paenian/bb8/bb8_club/PLAN B Body Panel Decals/Plan B Decal 1.jpg

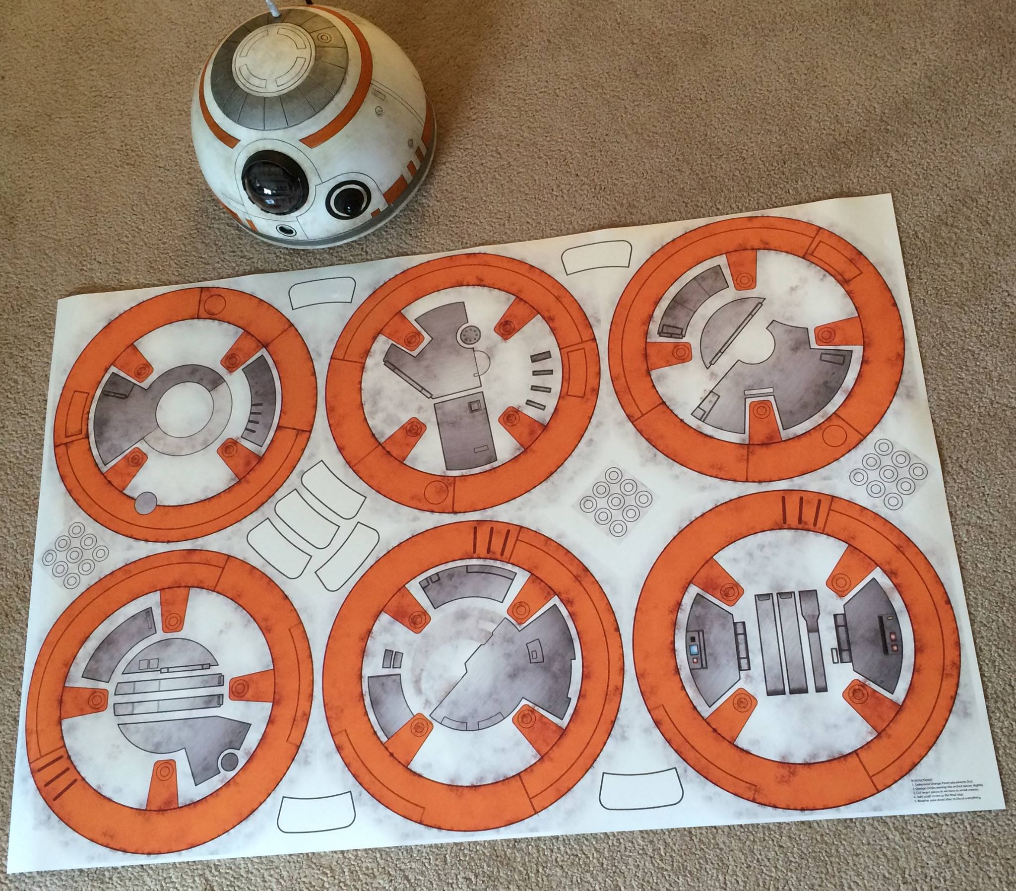
bb8_club/PLAN B Body Panel Decals/Plan B Decal 1.jpg
