paenian/bb8/bb8_club/Dome STL Files/Quarter Cut STL/READ ME - T&M BB8 Quarter Cut Part Files.rtf

For those with smaller X & Y build areas, like the FlashForge, Dremel, MakerBot Mini. Tiny has developed these Quarter Cut pieces.

These work just like the regular pieces, however instead of being 3 pieces to make a complete part, such as Dome Ring, Dome Skirt or even the Dome Panels, it requires you to print all 4 pieces.

The Dome Ring, you will notice is just 1 (one) STL part file, however you will need to print the file 4 times. This is indicated in the file name of the part by the x4 nomenclature.

Where as the Dome Skirt is actually only 2 (two) STL part files, and you will print each of those twice (x4). This is indicated in the file name of the part by the x2 nomenclature.
