paenian/bb8/bb8_club/Dome STL Files/Logic Mesh.pdf

LED Panel Mesh Dome

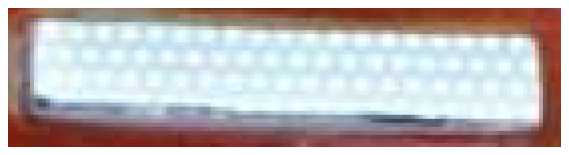
[picture p26: figure]

Approx. 23mm x 4mm
