paenian/bb8/bb8_club/Body Stage STL Files/T&M Body Panel Orientation -Sheet Layout.pdf

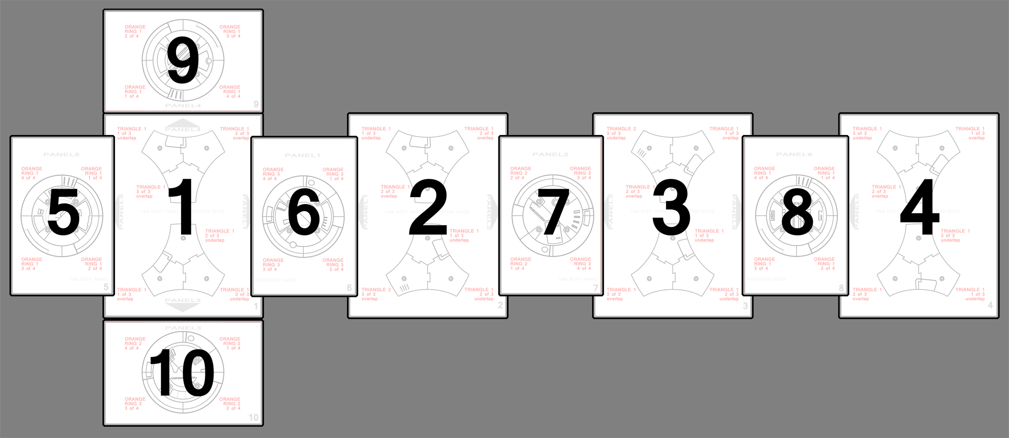
[picture p27: page 1]
