paenian/bb8/bb8_club/Body Stage STL Files/Orange Rings/Orange Ring 1 Orientation.jpg

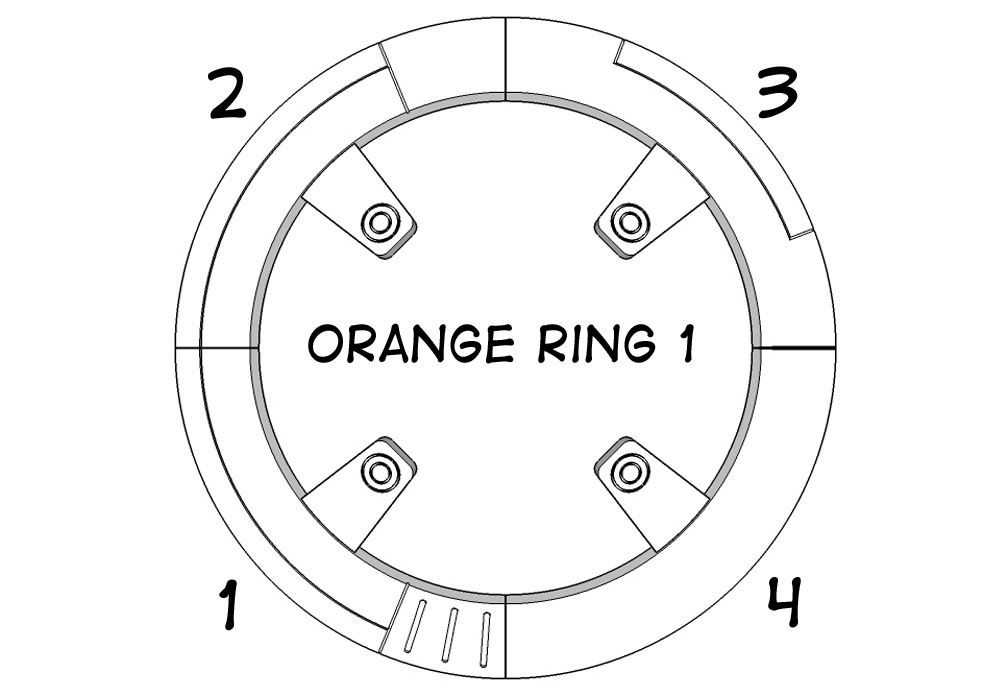
bb8_club/Body Stage STL Files/Orange Rings/Orange Ring 1 Orientation.jpg
