paenian/bb8/bb8_club/Body Stage STL Files/Orange Rings/Orange Ring 3 Orientation.jpg

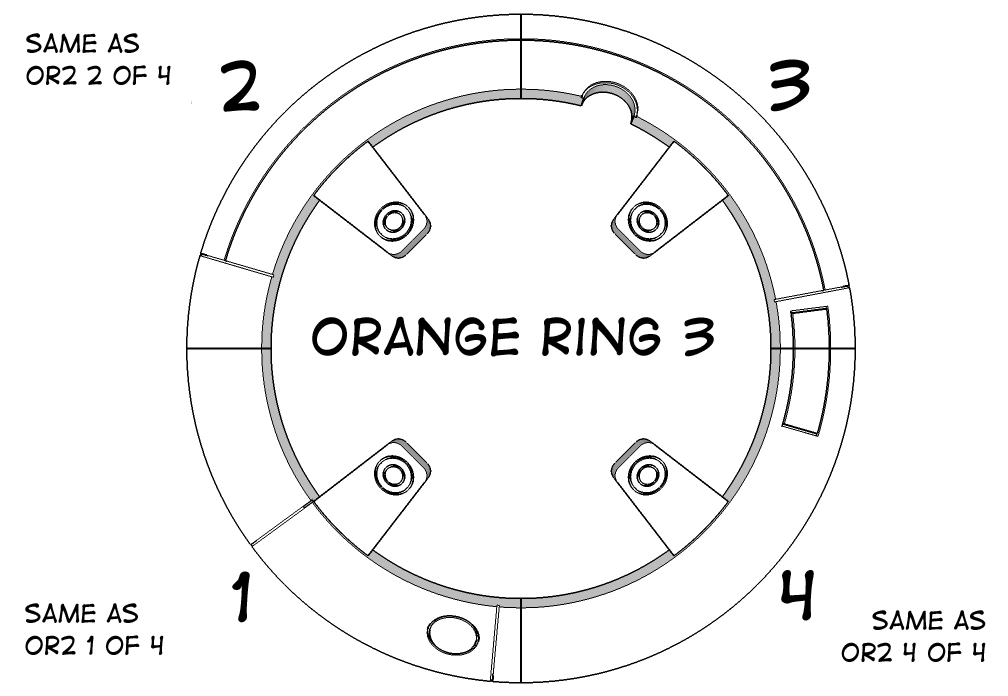
bb8_club/Body Stage STL Files/Orange Rings/Orange Ring 3 Orientation.jpg
