paenian/bb8/bb8_club/BB-8 Parts for Large Format Printers/Triangle 2.stl

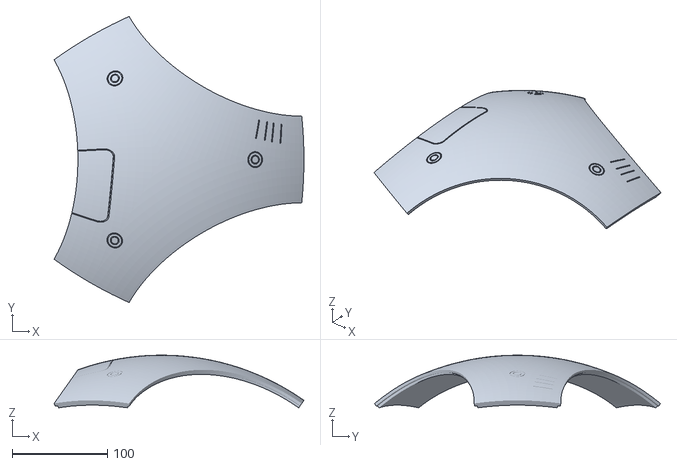
[picture p31: CAD file, 2018-01-01]
bb8_club/BB-8 Parts for Large Format Printers/Triangle 2.stl
262.7 x 300.6 x 55.4
