paenian/bb8/bb8_club/Body Stage STL Files/Panels/Panel 4 V506mm 1 of 2 -1mm.stl

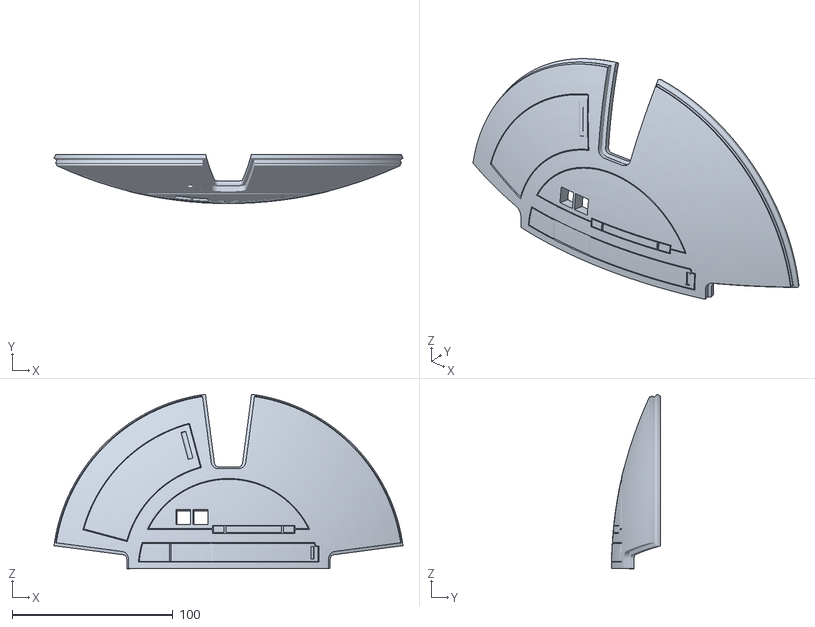
[picture p33: CAD file, 2018-01-01]
bb8_club/Body Stage STL Files/Panels/Panel 4 V506mm 1 of 2 -1mm.stl
217.2 x 30.6 x 108.6
