paenian/bb8/bb8_club/Body Stage STL Files/Triangles/Triangle2 - 3 of 3 - underlap.stl

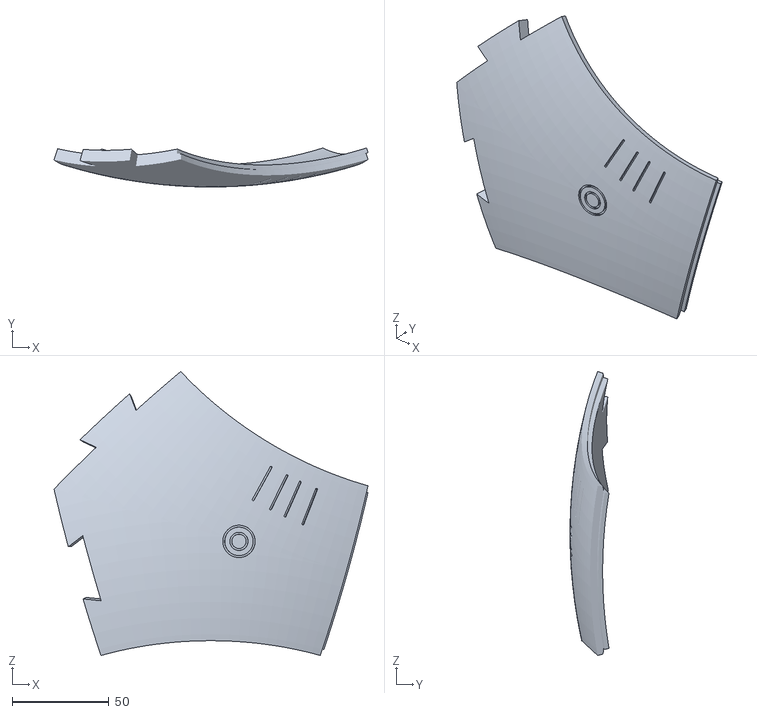
[picture p34: CAD file, 2018-01-01]
bb8_club/Body Stage STL Files/Triangles/Triangle2 - 3 of 3 - underlap.stl
162.3 x 20.2 x 146.8
