paenian/bb8/bb8_club/Dome STL Files/BB8 Pie Panel 1 V2 mag.stl

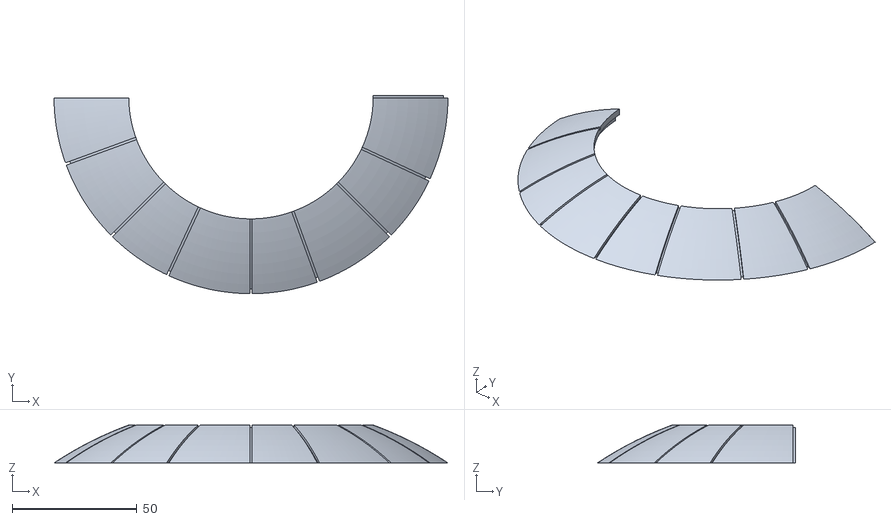
[picture p35: CAD file, 2018-01-01]
bb8_club/Dome STL Files/BB8 Pie Panel 1 V2 mag.stl
158.0 x 79.5 x 15.2
