paenian/bb8/bb8_club/Dome STL Files/Quarter Cut STL/BB8 Dome Ring QTR x4.stl

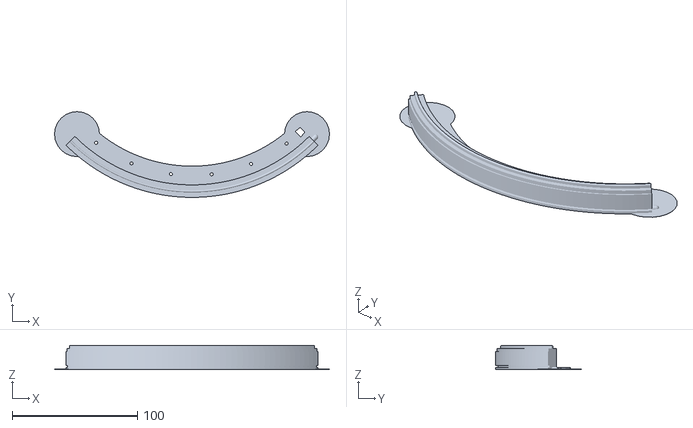
[picture p36: CAD file, 2018-01-01]
bb8_club/Dome STL Files/Quarter Cut STL/BB8 Dome Ring QTR x4.stl
219.8 x 68.6 x 19.4
