paenian/bb8/bb8_club/Hamster/BMM Tube Template v2.stl

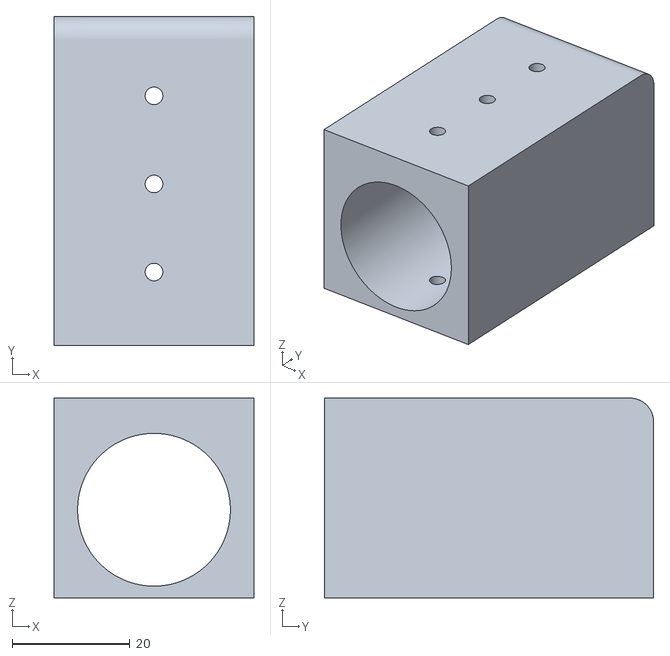
[picture p37: CAD file, 2018-01-01]
bb8_club/Hamster/BMM Tube Template v2.stl
34.0 x 56.0 x 34.0
