paenian/bb8/body/cuboctahedron/pyramid.stl

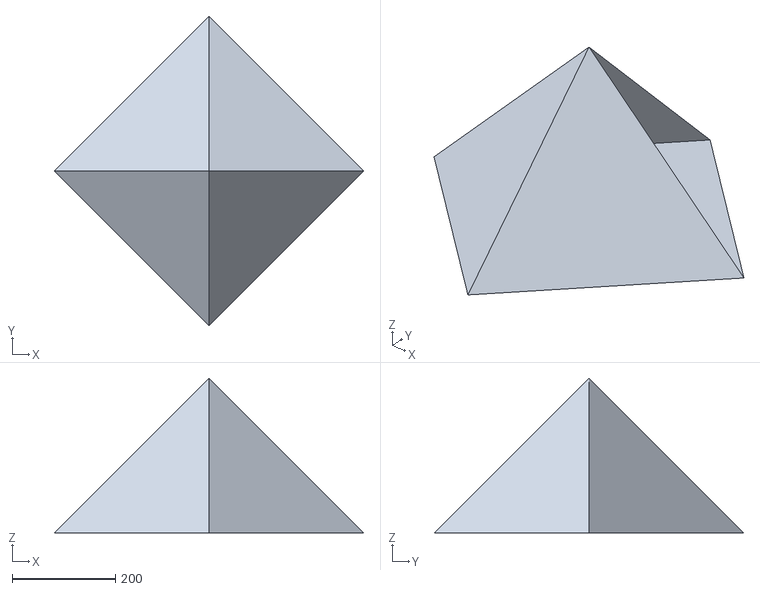
[picture p38: CAD file, 2017-08-08]
body/cuboctahedron/pyramid.stl
600.0 x 600.0 x 300.0
