paenian/bb8/body/rhombicuboctahedron/assembled/face4.stl

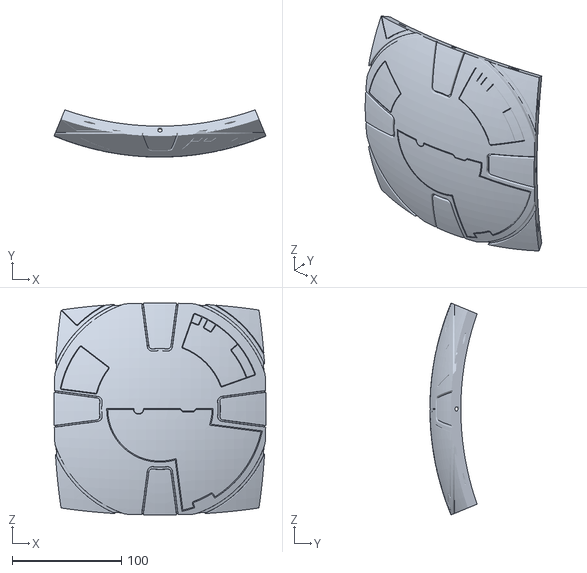
[picture p39: CAD file, 2016-05-04]
body/rhombicuboctahedron/assembled/face4.stl
194.3 x 43.3 x 194.2
