paenian/bb8/body/rhombicuboctahedron/assembled2/face24.stl

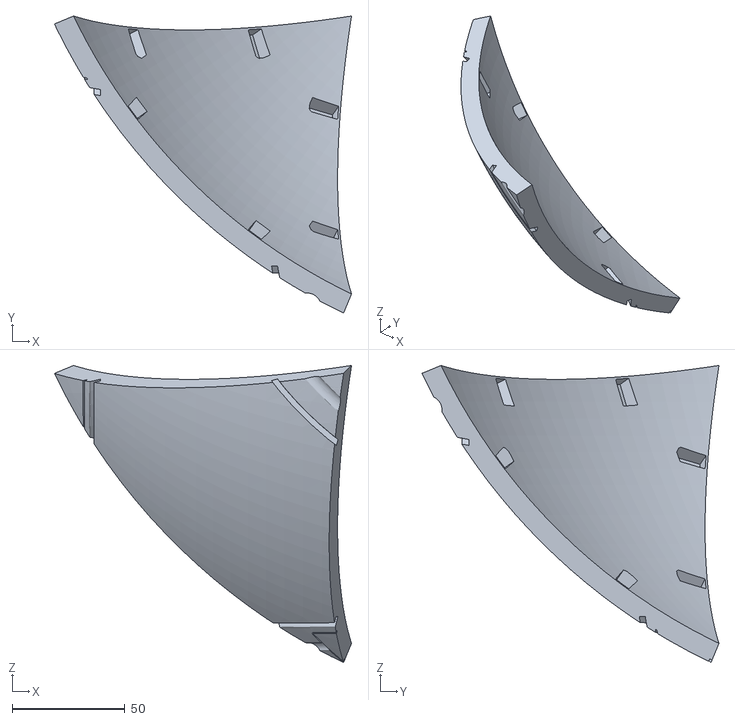
[picture p40: CAD file, 2016-05-06]
body/rhombicuboctahedron/assembled2/face24.stl
131.8 x 131.8 x 131.8
