paenian/bb8/body/rhombicuboctahedron/dodeca_half.stl

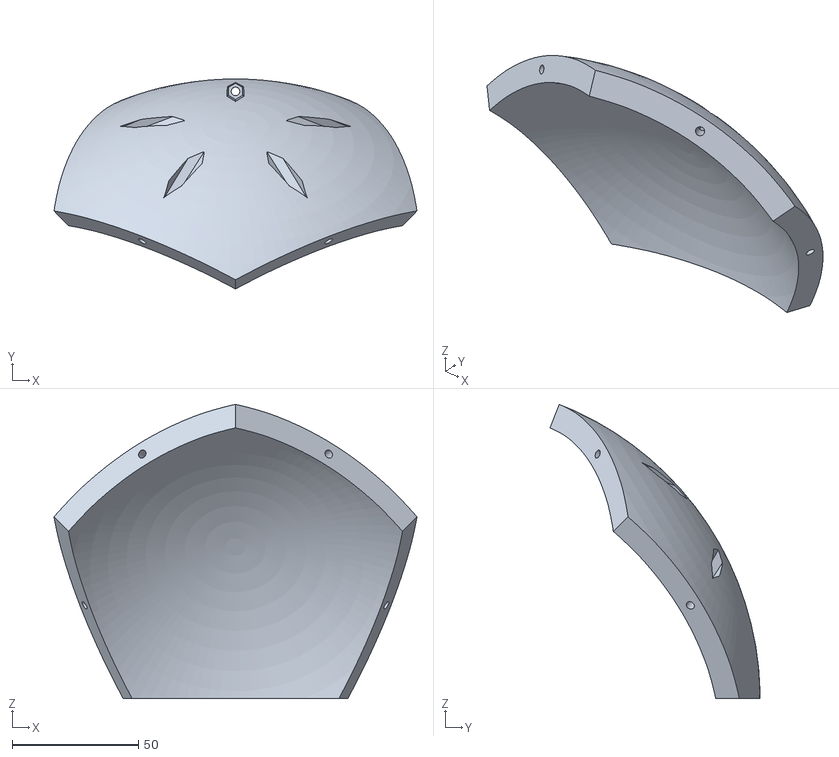
[picture p41: CAD file, 2016-04-13]
body/rhombicuboctahedron/dodeca_half.stl
143.5 x 83.1 x 116.3
