paenian/bb8/body/rhombicuboctahedron/printing/face0.stl

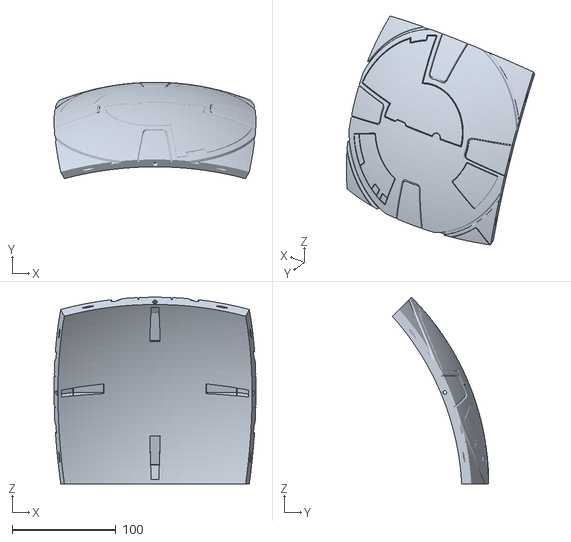
[picture p42: CAD file, 2016-05-04]
body/rhombicuboctahedron/printing/face0.stl
194.3 x 92.7 x 179.5
