paenian/bb8/body/rhombicuboctahedron/printing2/face14.stl

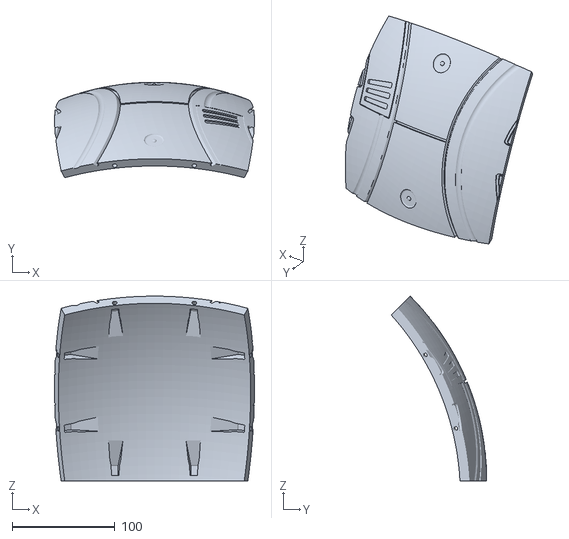
[picture p43: CAD file, 2016-05-06]
body/rhombicuboctahedron/printing2/face14.stl
194.3 x 92.8 x 179.5
