paenian/bb8/body/rhombicuboctahedron_clean/assembled/face21.stl

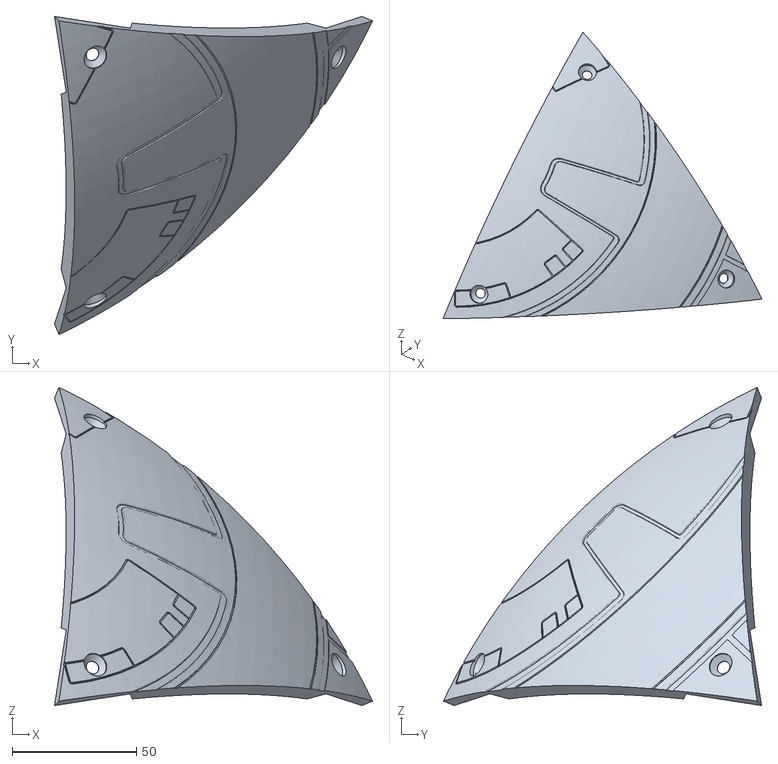
[picture p44: CAD file, 2016-11-15]
body/rhombicuboctahedron_clean/assembled/face21.stl
128.1 x 128.1 x 128.1
