paenian/bb8/body/rhombicuboctahedron_clean/printing/face19.stl

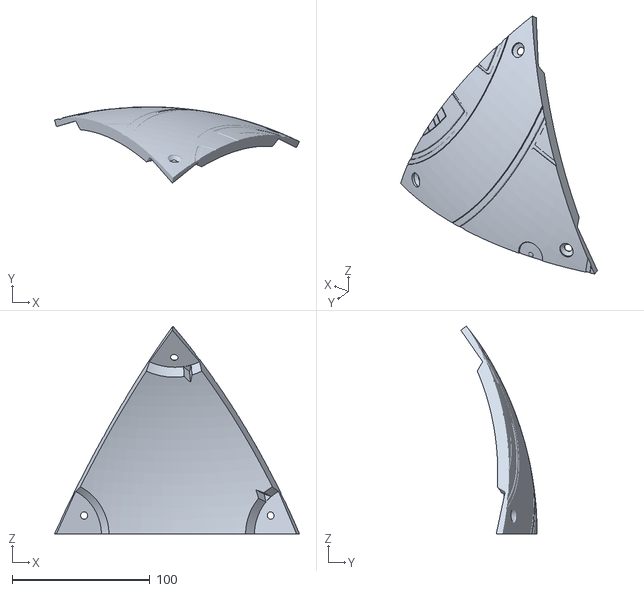
[picture p45: CAD file, 2016-11-15]
body/rhombicuboctahedron_clean/printing/face19.stl
178.0 x 55.5 x 150.9
