paenian/bb8/body/thermoformer/form_sixth.stl

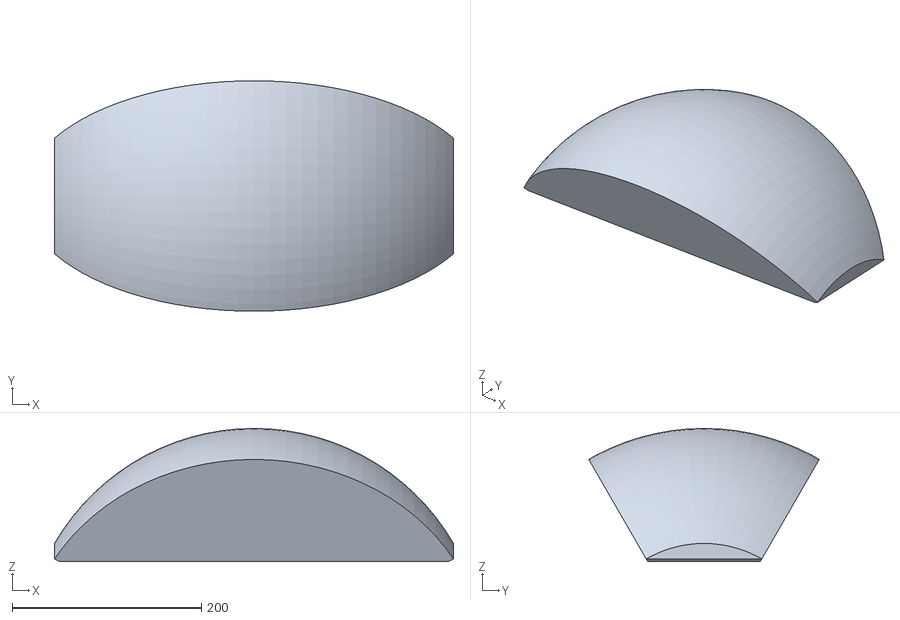
[picture p46: CAD file, 2016-06-22]
body/thermoformer/form_sixth.stl
421.4 x 243.4 x 140.6
