paenian/bb8/body/thermoformer/printing/waistband.stl

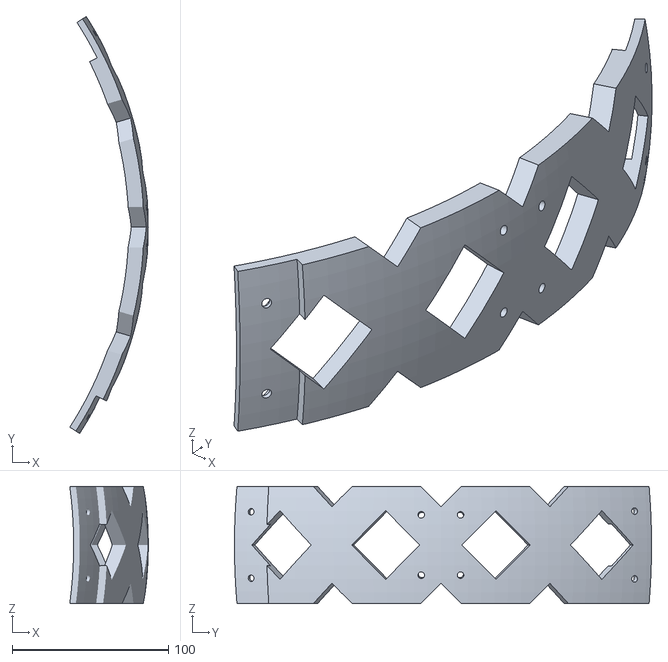
[picture p47: CAD file, 2016-08-10]
body/thermoformer/printing/waistband.stl
50.2 x 266.6 x 75.0
