paenian/bb8/code/edsjunk/Control/BodyBottom.stl

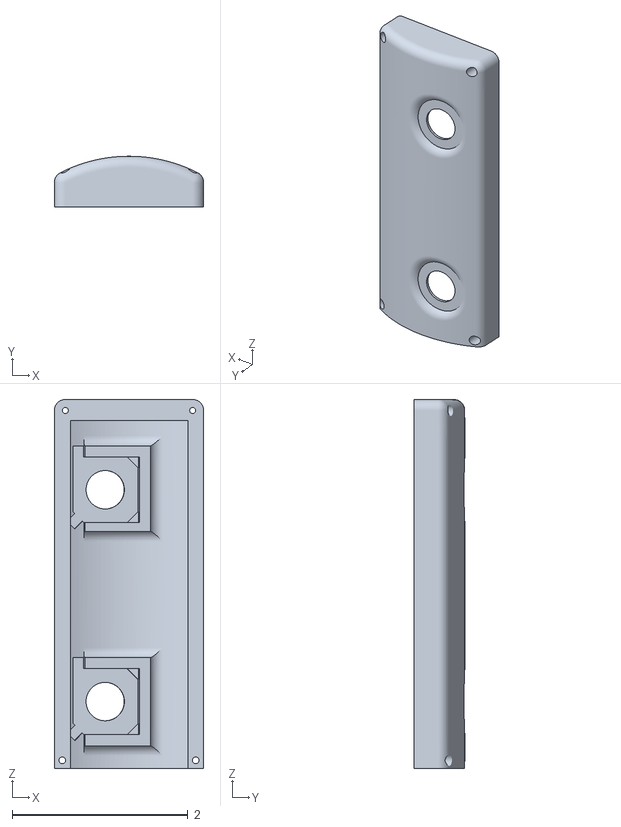
[picture p48: CAD file, 2016-06-22]
code/edsjunk/Control/BodyBottom.stl
1.70 x 0.575 x 4.20
