paenian/bb8/controller/top.stl

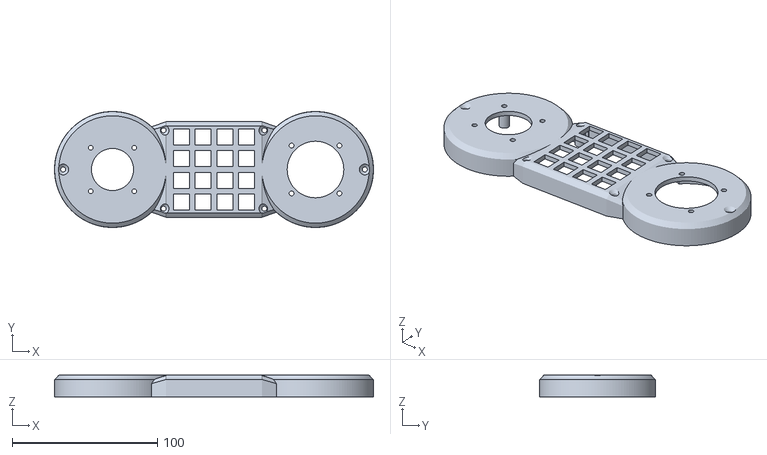
[picture p49: CAD file, 2017-02-14]
controller/top.stl
220.0 x 80.0 x 15.0
