paenian/bb8/hamster/battery_mount.stl

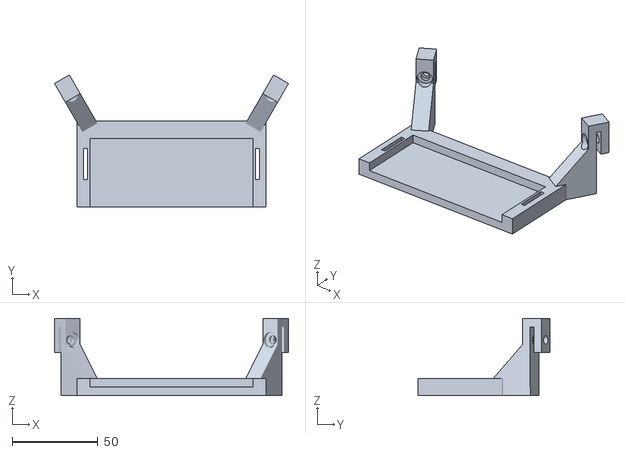
[picture p50: CAD file, 2017-02-20]
hamster/battery_mount.stl
136.2 x 76.9 x 45.0
