paenian/bb8/head/head_solid.stl

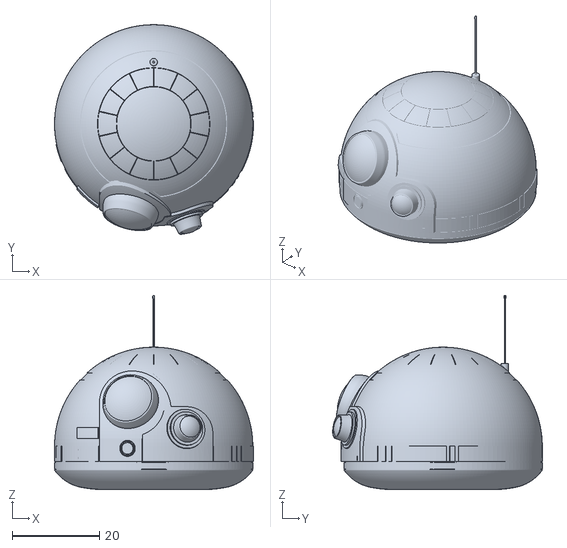
[picture p51: CAD file, 2016-05-02]
head/head_solid.stl
45.7 x 48.2 x 44.7
