paenian/bb8/ice_mold/head.stl

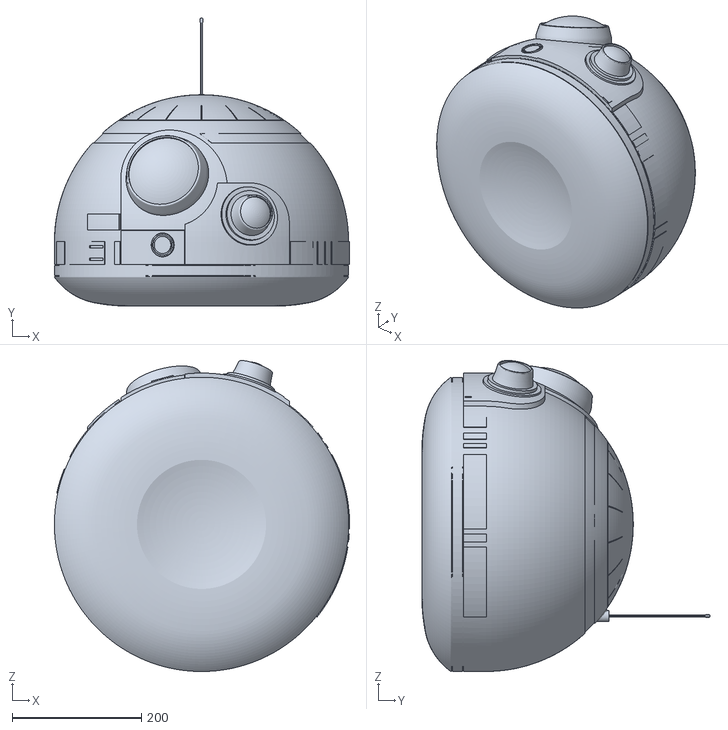
[picture p52: CAD file, 2016-10-14]
ice_mold/head.stl
457.5 x 447.0 x 482.0
