paenian/bb8/stand/center.stl

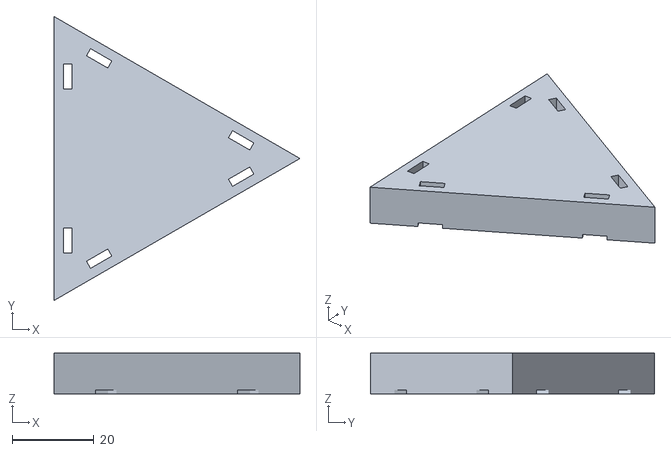
[picture p53: CAD file, 2016-06-21]
stand/center.stl
60.0 x 69.3 x 10.0
