paenian/bb8/bb8_club/BB-8 Parts for Large Format Printers/Dome Pie Panel 1-Piece.stl

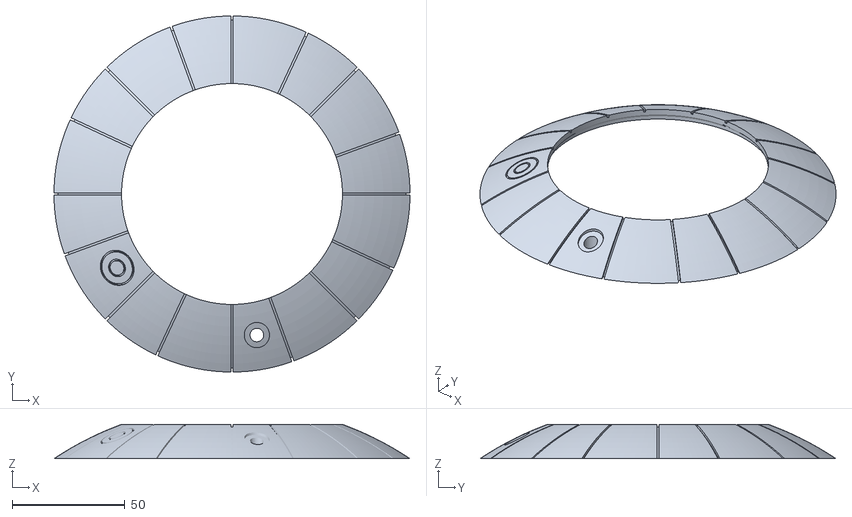
[picture p54: CAD file, 2018-01-01]
bb8_club/BB-8 Parts for Large Format Printers/Dome Pie Panel 1-Piece.stl
158.0 x 158.0 x 15.2
