paenian/bb8/bb8_club/Body Stage STL Files/Panels/Panel 5 V506mm 2 of 2 -1mm.stl

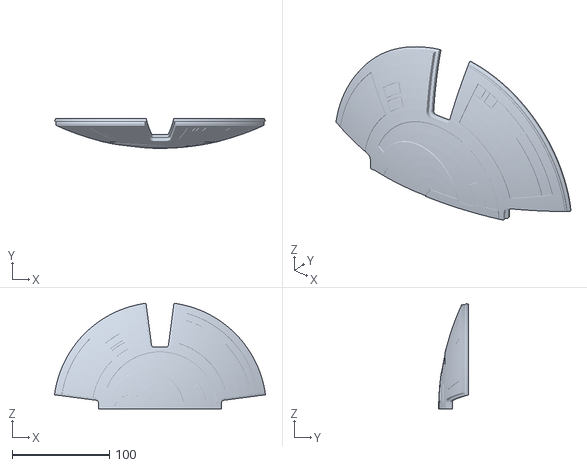
[picture p55: CAD file, 2018-01-01]
bb8_club/Body Stage STL Files/Panels/Panel 5 V506mm 2 of 2 -1mm.stl
217.2 x 30.6 x 108.6
