paenian/bb8/bb8_club/Body Stage STL Files/Triangles/Triangle1 - 2 of 3 - overlap.stl

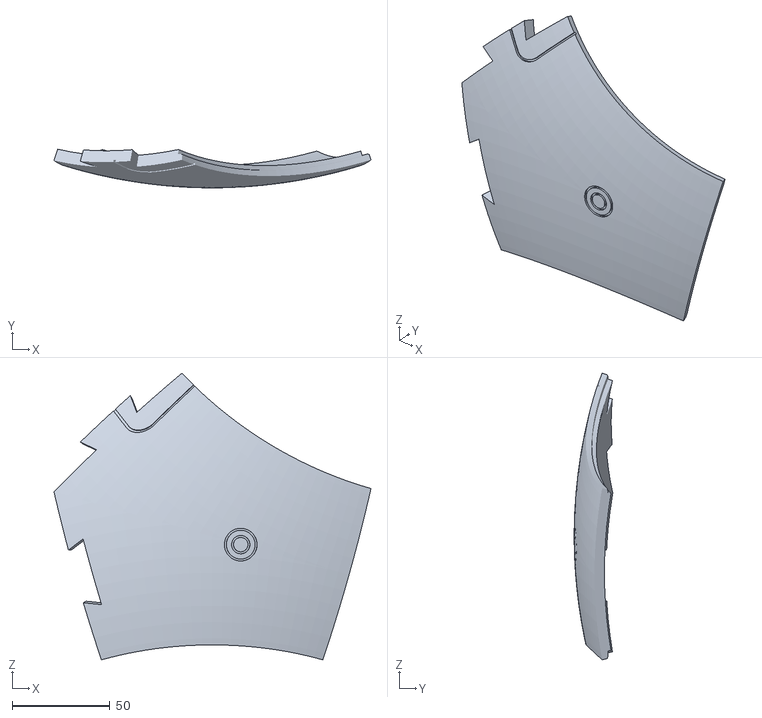
[picture p56: CAD file, 2018-01-01]
bb8_club/Body Stage STL Files/Triangles/Triangle1 - 2 of 3 - overlap.stl
162.3 x 19.8 x 146.8
