paenian/bb8/bb8_club/Dome STL Files/Holo LED Mount FIXED.stl

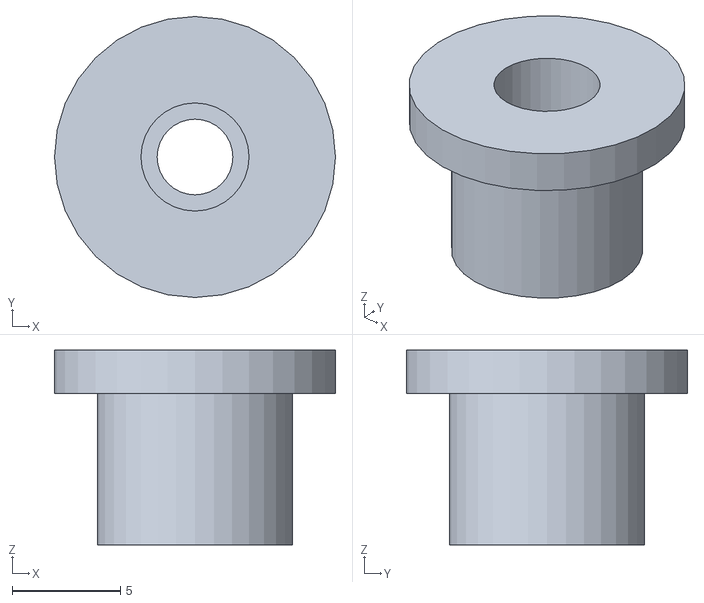
[picture p57: CAD file, 2018-01-01]
bb8_club/Dome STL Files/Holo LED Mount FIXED.stl
13.0 x 13.0 x 9.00
