paenian/bb8/bb8_club/Hamster/BMM Sides v2.stl

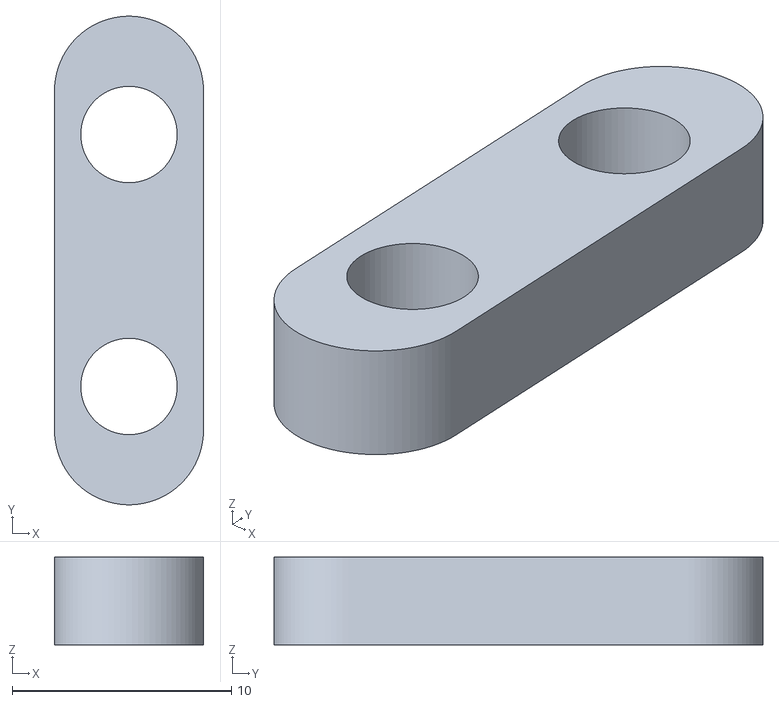
[picture p59: CAD file, 2018-01-01]
bb8_club/Hamster/BMM Sides v2.stl
6.80 x 22.3 x 4.00
