paenian/bb8/body/rhombicuboctahedron/assembled/face24.stl

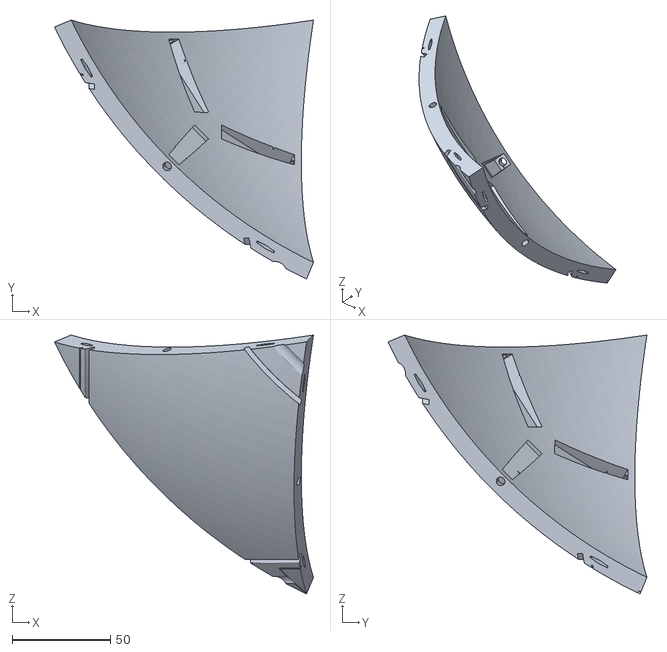
[picture p60: CAD file, 2016-05-04]
body/rhombicuboctahedron/assembled/face24.stl
131.8 x 131.8 x 131.8
