paenian/bb8/body/rhombicuboctahedron/assembled2/face8.stl

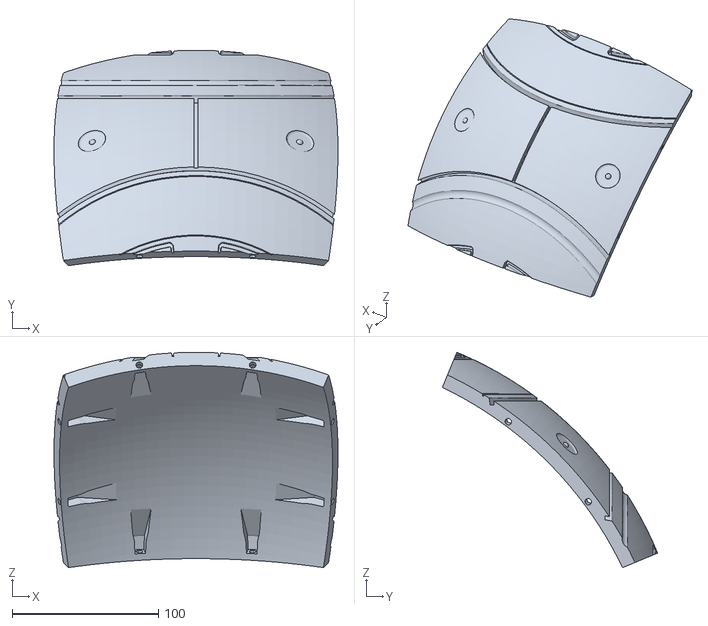
[picture p61: CAD file, 2016-05-06]
body/rhombicuboctahedron/assembled2/face8.stl
194.3 x 147.3 x 147.3
