paenian/bb8/body/rhombicuboctahedron/dodeca.stl

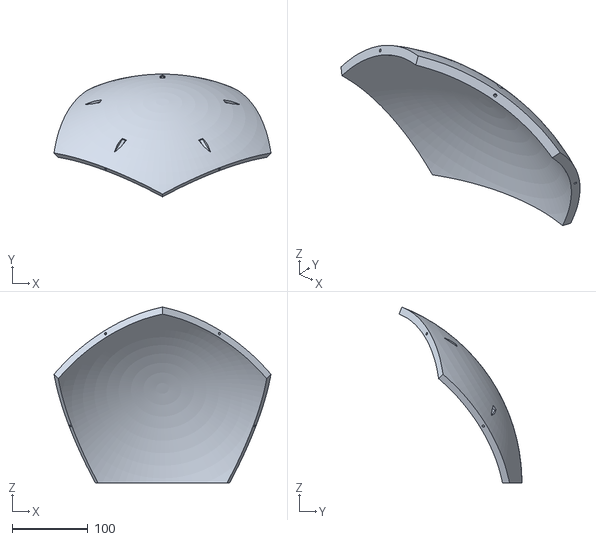
[picture p62: CAD file, 2016-04-13]
body/rhombicuboctahedron/dodeca.stl
287.1 x 162.5 x 232.7
