paenian/bb8/body/rhombicuboctahedron/printing2/face2.stl

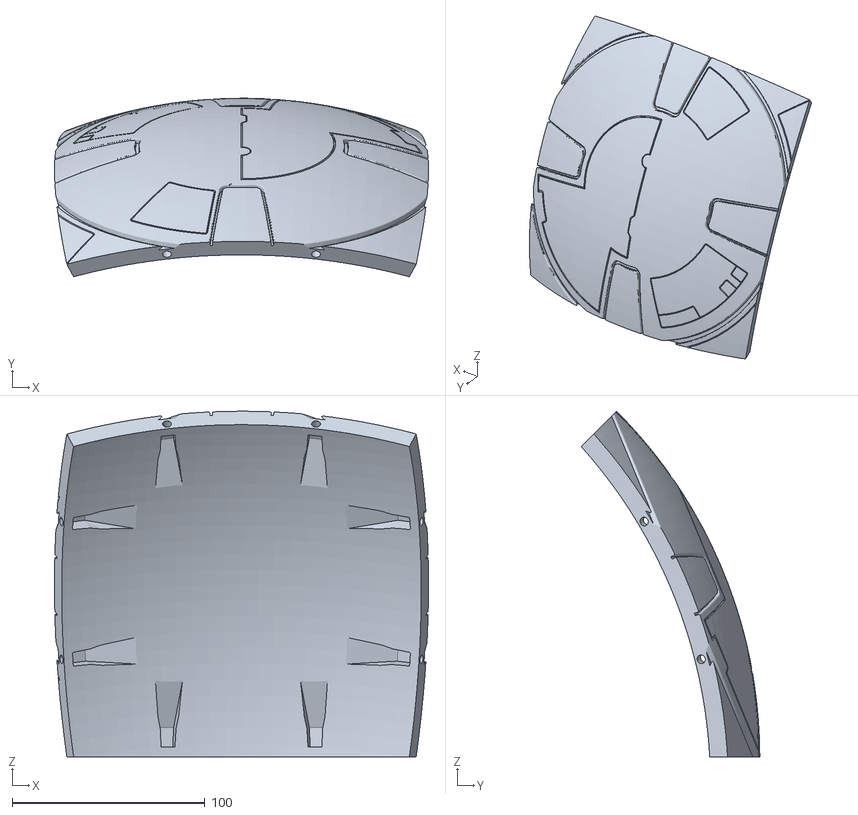
[picture p63: CAD file, 2016-05-06]
body/rhombicuboctahedron/printing2/face2.stl
194.3 x 92.8 x 179.5
