paenian/bb8/body/rhombicuboctahedron_clean/assembled/face14.stl

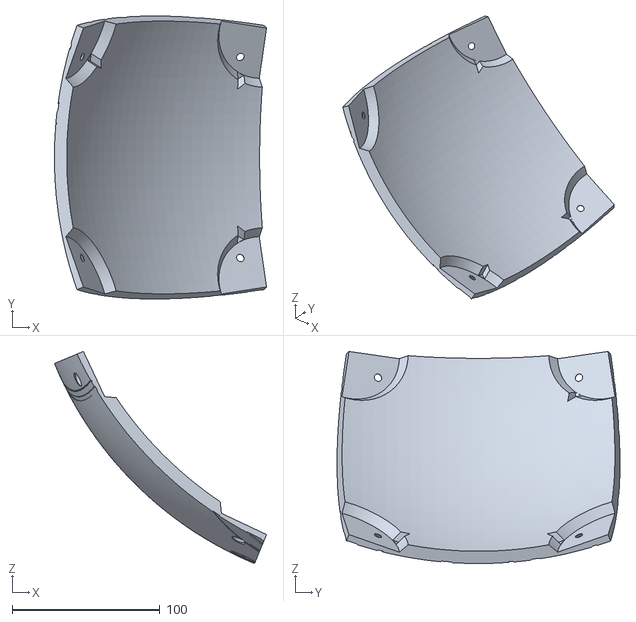
[picture p64: CAD file, 2016-11-15]
body/rhombicuboctahedron_clean/assembled/face14.stl
143.4 x 191.3 x 143.4
