paenian/bb8/body/thermoformer/printing/rightgear.stl

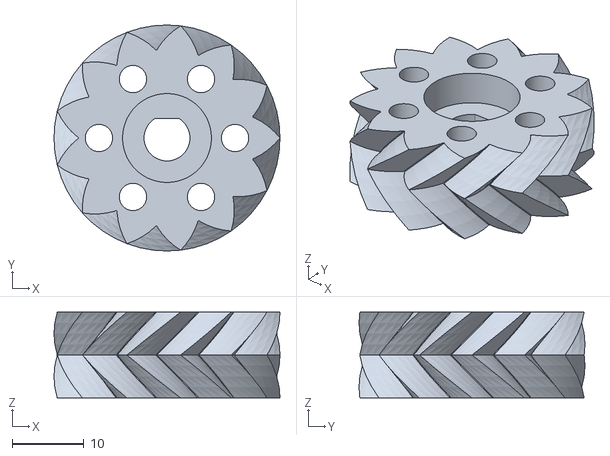
[picture p65: CAD file, 2016-08-10]
body/thermoformer/printing/rightgear.stl
31.6 x 31.6 x 12.0
