paenian/bb8/body/thermoformer/slice_sixth.stl

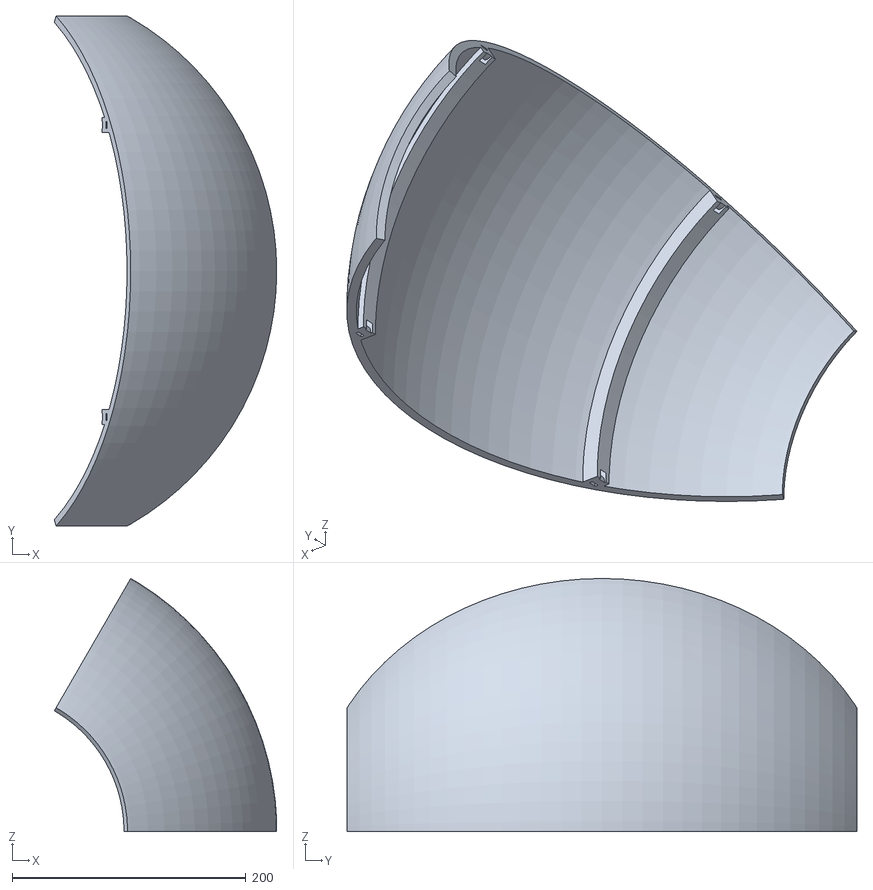
[picture p66: CAD file, 2016-06-22]
body/thermoformer/slice_sixth.stl
190.3 x 435.9 x 216.4
