paenian/bb8/code/edsjunk/Control/BodyTop.stl

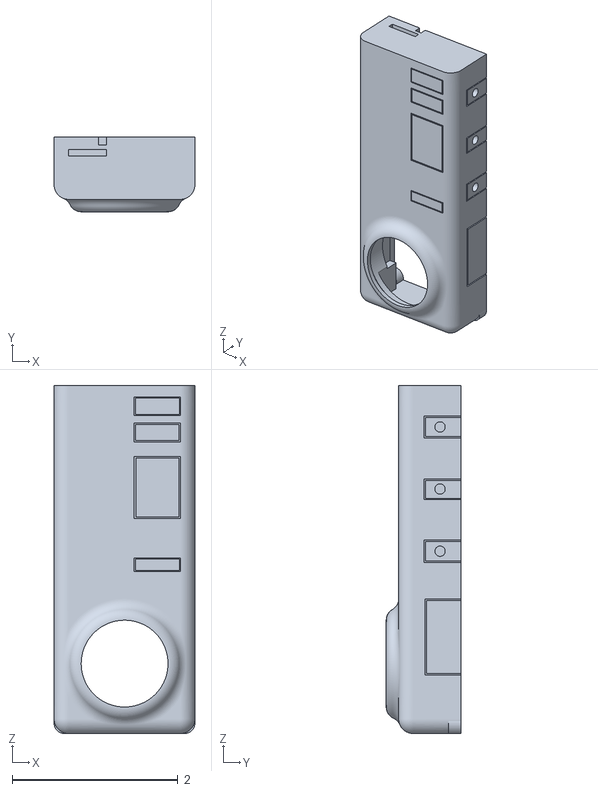
[picture p67: CAD file, 2016-06-22]
code/edsjunk/Control/BodyTop.stl
1.70 x 0.9 x 4.20
