paenian/bb8/controller/bot.stl

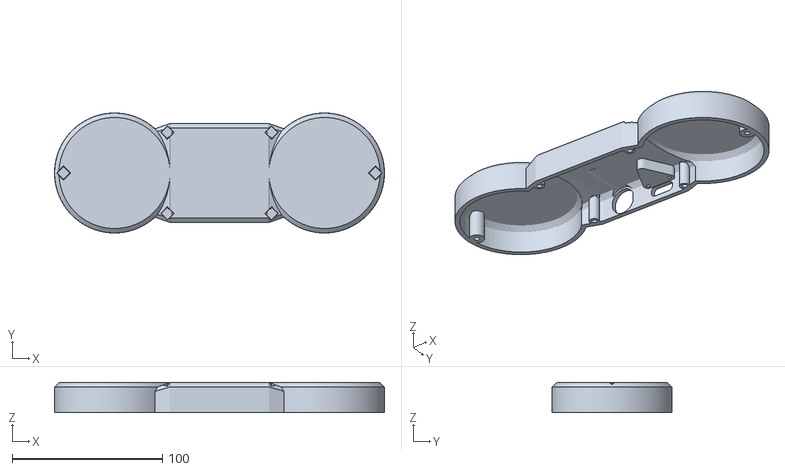
[picture p68: CAD file, 2017-02-14]
controller/bot.stl
220.0 x 80.0 x 20.0
