paenian/bb8/hamster/idler_lift_arm.stl

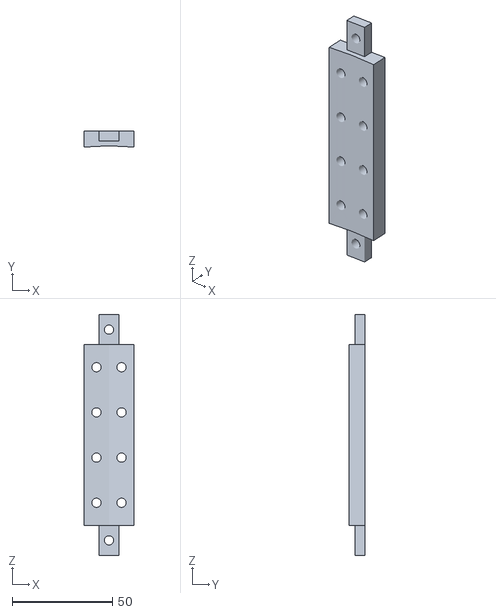
[picture p69: CAD file, 2017-02-14]
hamster/idler_lift_arm.stl
25.0 x 8.19 x 120.0
