paenian/bb8/stand/arm.stl

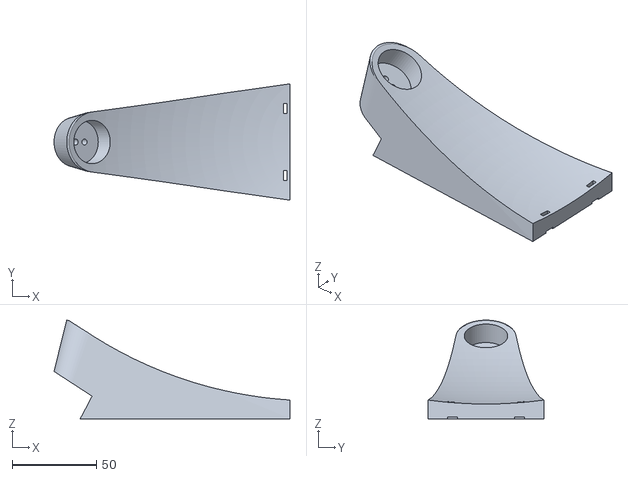
[picture p70: CAD file, 2016-06-21]
stand/arm.stl
140.2 x 69.1 x 58.7
