paenian/bb8/bb8_club/Body Stage STL Files/Orange Rings/Orange Ring 1 V506mm 1 of 4 -1mm.stl

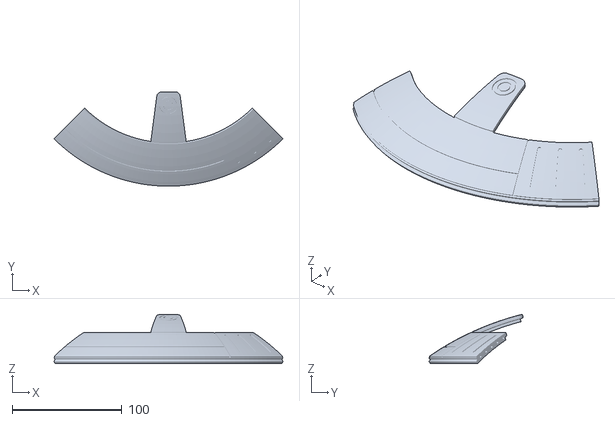
[picture p71: CAD file, 2018-01-01]
bb8_club/Body Stage STL Files/Orange Rings/Orange Ring 1 V506mm 1 of 4 -1mm.stl
208.8 x 86.1 x 45.0
