paenian/bb8/bb8_club/Dome STL Files/BB8 PSI Ring V1.stl

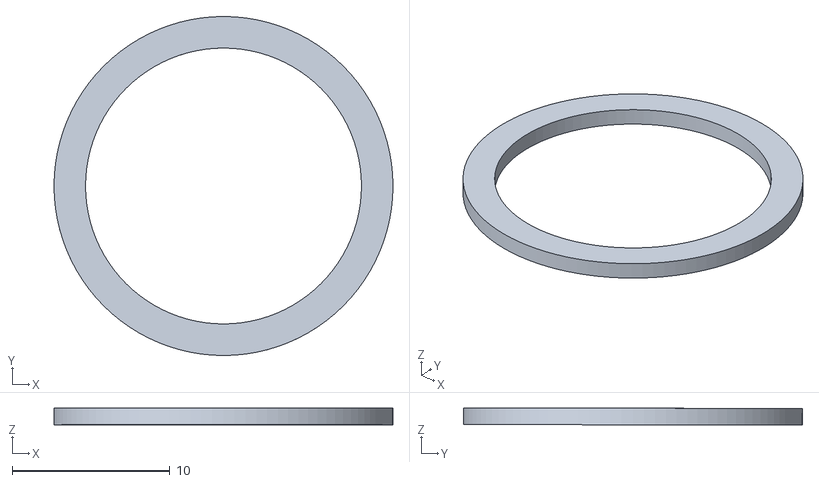
[picture p72: CAD file, 2018-01-01]
bb8_club/Dome STL Files/BB8 PSI Ring V1.stl
21.5 x 21.5 x 1.07
