paenian/bb8/bb8_club/Dome STL Files/Quarter Cut STL/BB8 Dome Panel 3 Mag QTR.stl

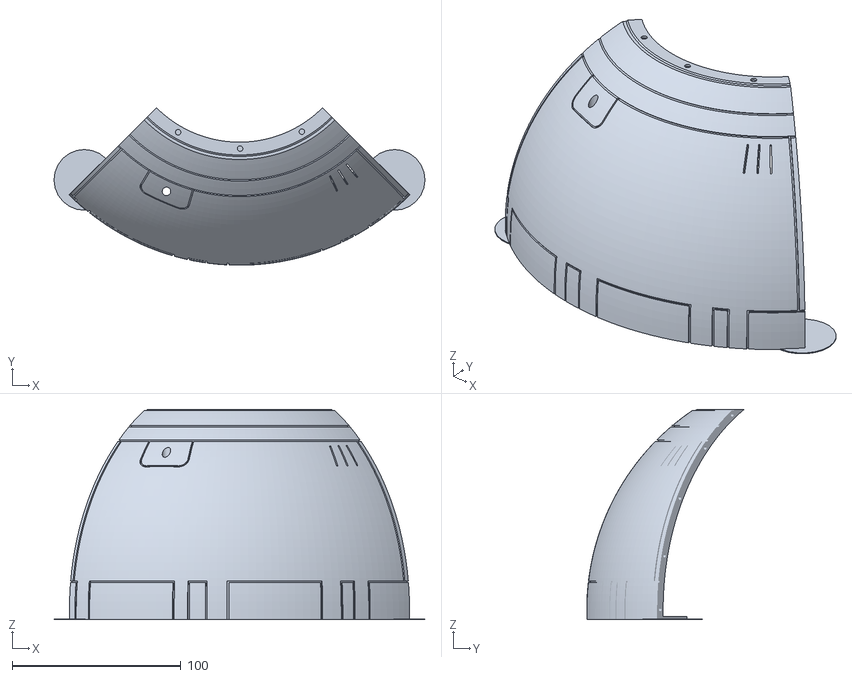
[picture p73: CAD file, 2018-01-01]
bb8_club/Dome STL Files/Quarter Cut STL/BB8 Dome Panel 3 Mag QTR.stl
219.8 x 93.3 x 124.6
