paenian/bb8/body/rhombicuboctahedron/printing2/face20.stl

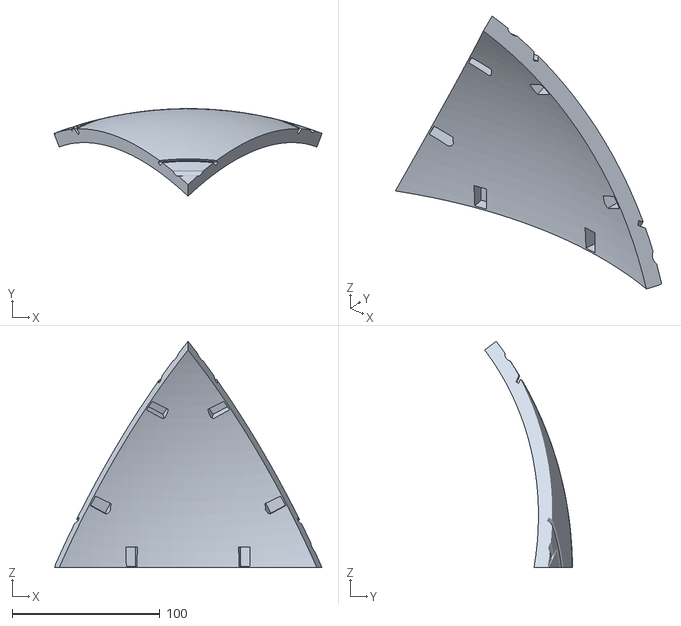
[picture p74: CAD file, 2016-05-06]
body/rhombicuboctahedron/printing2/face20.stl
181.3 x 59.3 x 153.2
