paenian/bb8/body/rhombicuboctahedron/tetra.stl

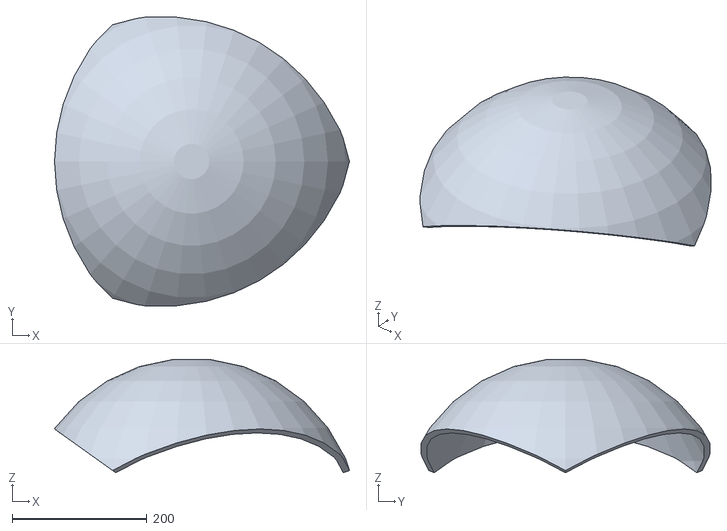
[picture p75: CAD file, 2016-04-01]
body/rhombicuboctahedron/tetra.stl
437.5 x 428.2 x 168.3
