paenian/bb8/body/rhombicuboctahedron_clean/printing/face1.stl

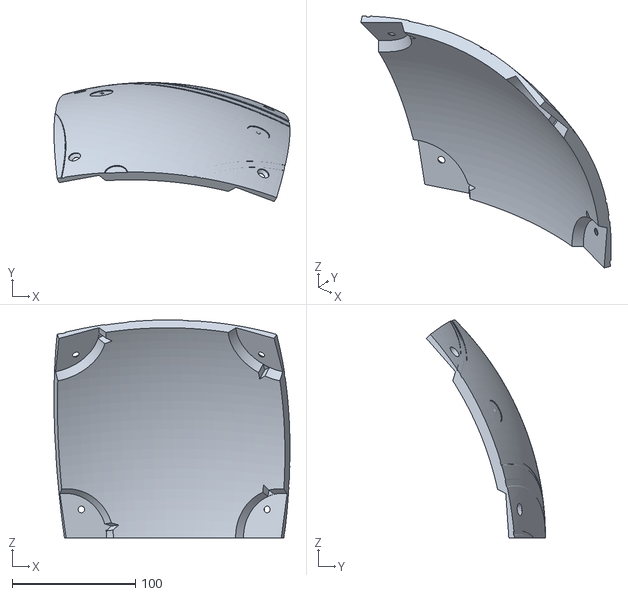
[picture p76: CAD file, 2016-11-15]
body/rhombicuboctahedron_clean/printing/face1.stl
191.4 x 96.5 x 176.7
