paenian/bb8/body/thermoformer/printing/leftmotor_carrier.stl

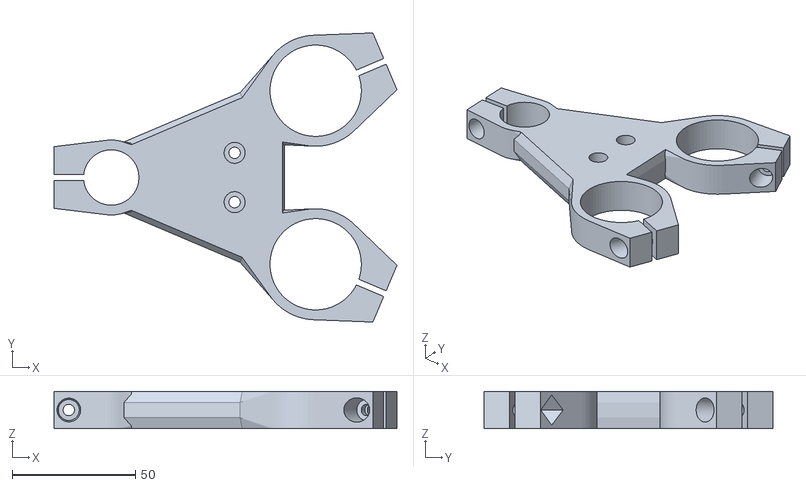
[picture p77: CAD file, 2016-08-10]
body/thermoformer/printing/leftmotor_carrier.stl
139.0 x 117.2 x 15.0
