paenian/bb8/hamster/spine.stl

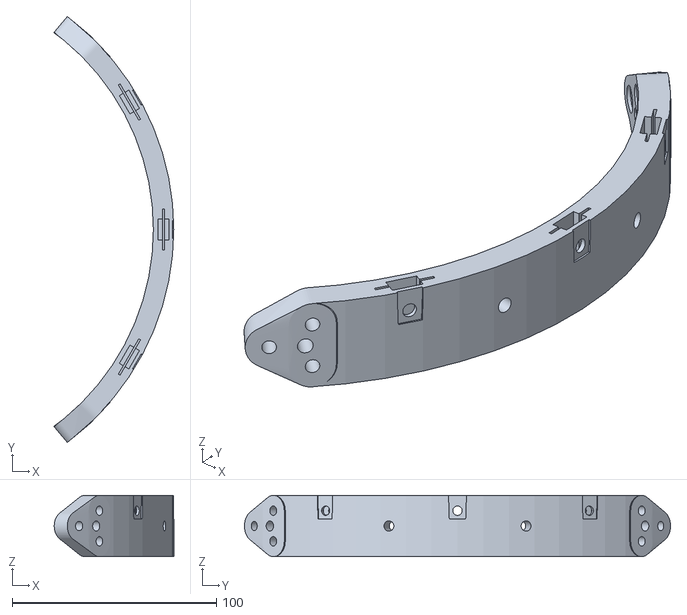
[picture p78: CAD file, 2017-02-14]
hamster/spine.stl
58.6 x 208.8 x 30.0
