paenian/bb8/bb8_club/Dome STL Files/BB8 Radar Surround 2of2 V15 Option.stl

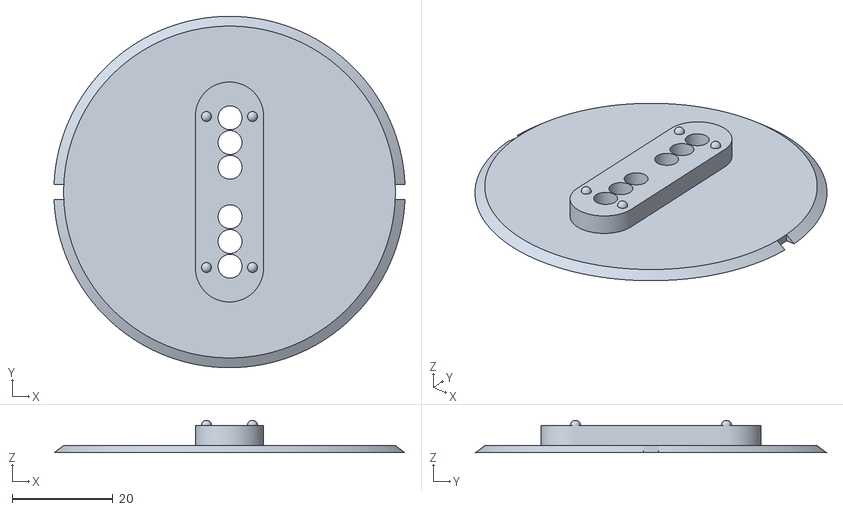
[picture p79: CAD file, 2018-01-01]
bb8_club/Dome STL Files/BB8 Radar Surround 2of2 V15 Option.stl
69.7 x 69.8 x 6.45
