paenian/bb8/body/rhombicuboctahedron/printing/face25.stl

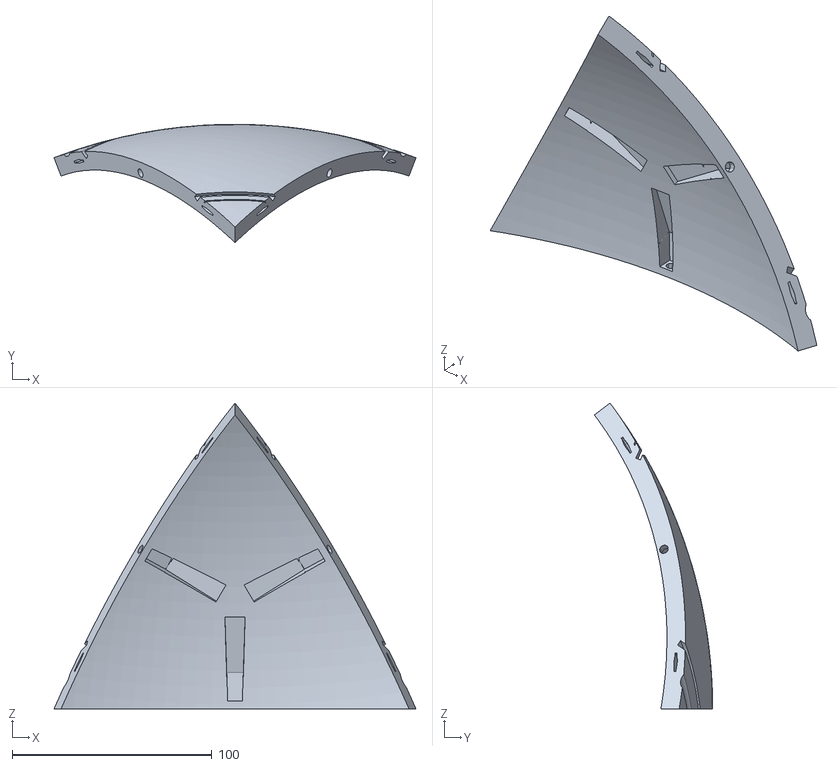
[picture p80: CAD file, 2016-05-04]
body/rhombicuboctahedron/printing/face25.stl
181.4 x 59.3 x 153.3
