paenian/bb8/body/thermoformer/printing/leftcapcap.stl

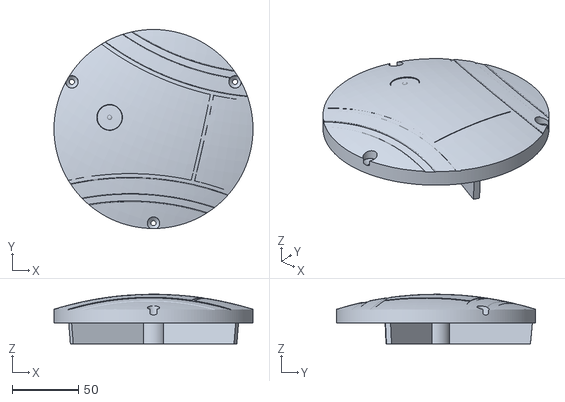
[picture p81: CAD file, 2016-08-10]
body/thermoformer/printing/leftcapcap.stl
150.0 x 150.0 x 37.4
