paenian/bb8/hamster/motor_support_bearing.stl

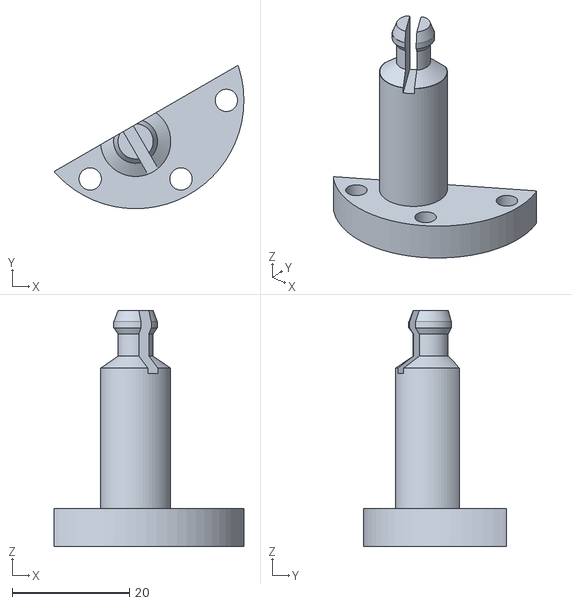
[picture p82: CAD file, 2017-02-14]
hamster/motor_support_bearing.stl
32.4 x 24.5 x 40.3
