paenian/bb8/bb8_club/Dome STL Files/BB8 PSI Cover v3 wo.stl

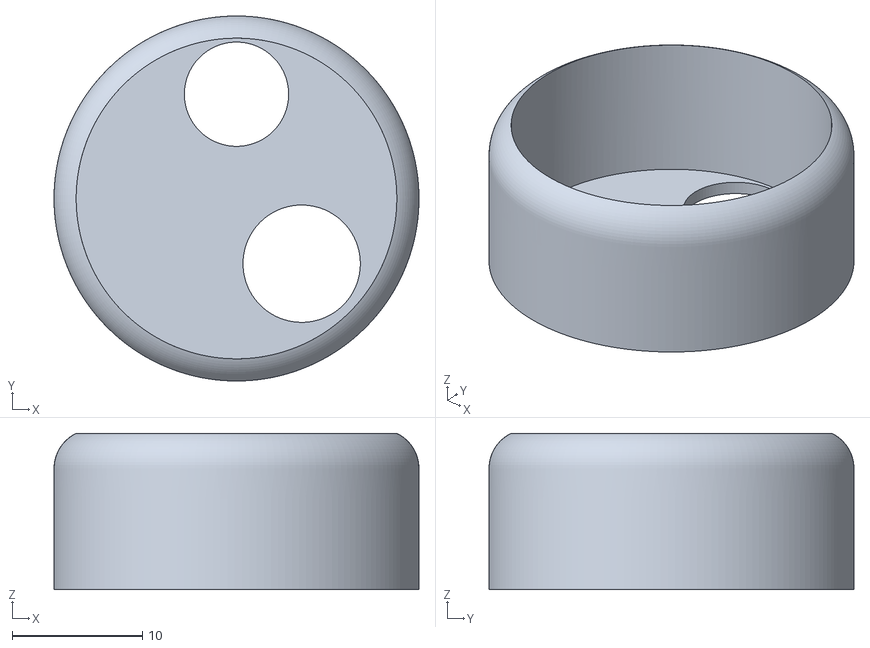
[picture p83: CAD file, 2018-01-01]
bb8_club/Dome STL Files/BB8 PSI Cover v3 wo.stl
28.0 x 28.0 x 12.0
