paenian/bb8/bb8_club/Dome STL Files/Quarter Cut STL/BB8 Dome Skirt QTR 1 x2.stl

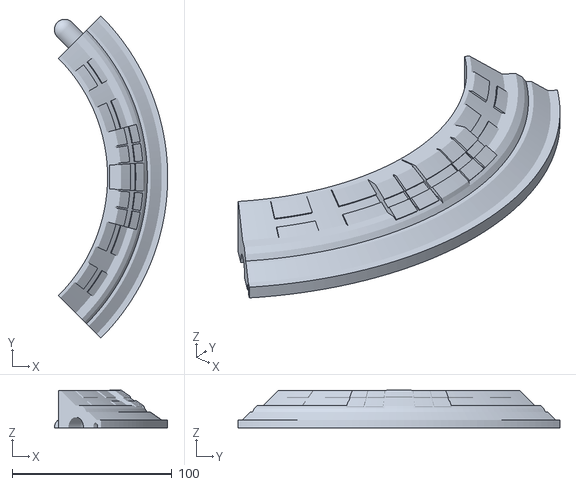
[picture p84: CAD file, 2018-01-01]
bb8_club/Dome STL Files/Quarter Cut STL/BB8 Dome Skirt QTR 1 x2.stl
70.9 x 201.5 x 23.7
