paenian/bb8/body/rhombicuboctahedron/assembled2/face6.stl

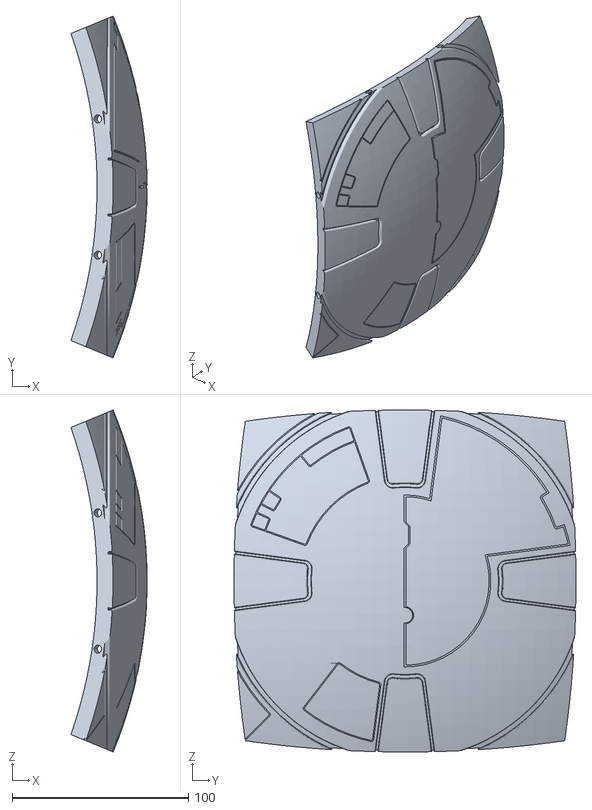
[picture p85: CAD file, 2016-05-06]
body/rhombicuboctahedron/assembled2/face6.stl
43.4 x 194.3 x 194.3
