paenian/bb8/body/rhombicuboctahedron_clean/printing/square.stl

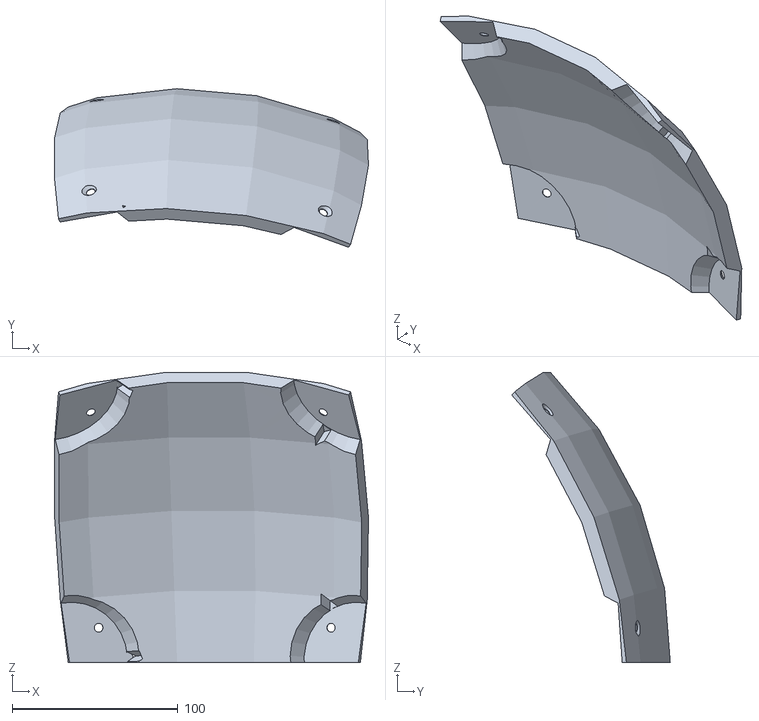
[picture p87: CAD file, 2016-11-15]
body/rhombicuboctahedron_clean/printing/square.stl
189.7 x 95.8 x 175.5
