paenian/bb8/body/thermoformer/printing/pendulum.stl

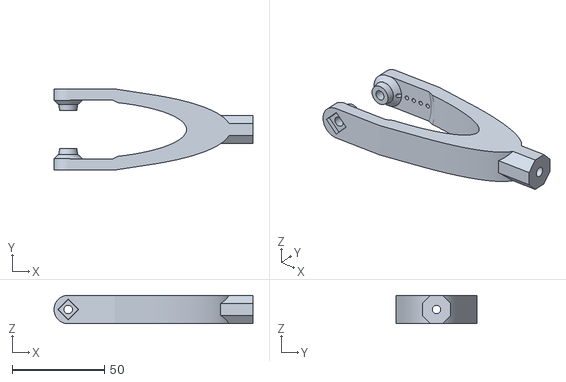
[picture p88: CAD file, 2016-08-10]
body/thermoformer/printing/pendulum.stl
107.7 x 44.0 x 15.4
