paenian/bb8/hamster/idler_mount_arm.stl

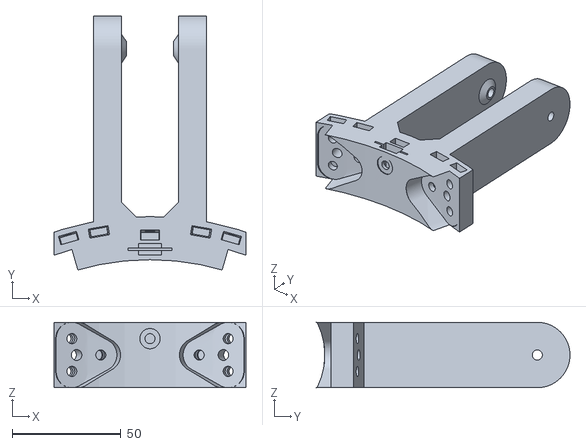
[picture p89: CAD file, 2017-02-14]
hamster/idler_mount_arm.stl
88.0 x 116.5 x 30.0
