paenian/bb8/bb8_club/Dome STL Files/PSI LED Mount FIXED.stl

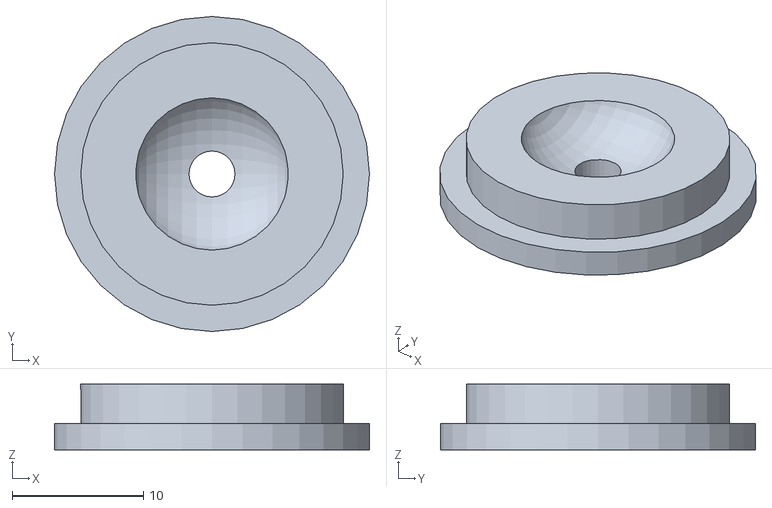
[picture p90: CAD file, 2018-01-01]
bb8_club/Dome STL Files/PSI LED Mount FIXED.stl
24.0 x 24.0 x 5.00
