paenian/bb8/hamster/motor_mount_arm.stl

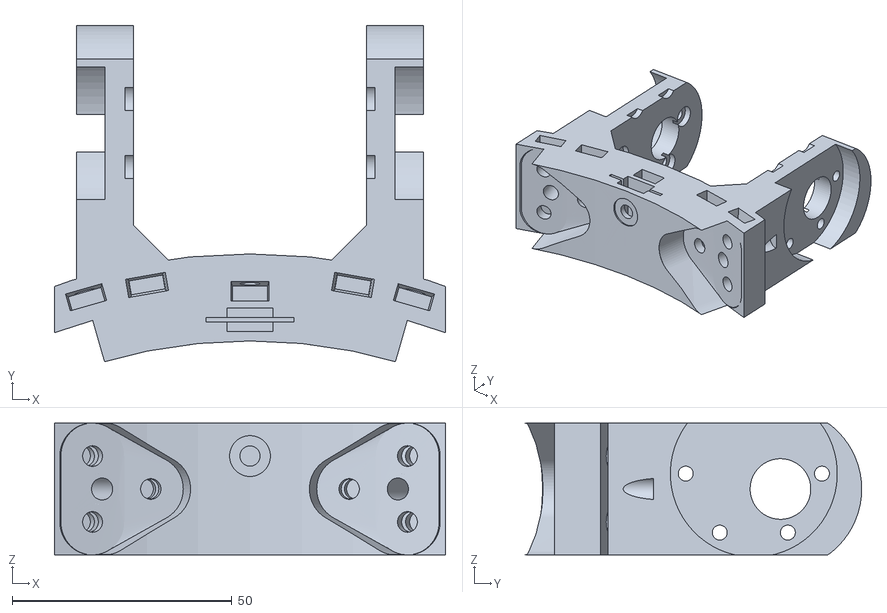
[picture p91: CAD file, 2017-02-14]
hamster/motor_mount_arm.stl
89.0 x 76.6 x 30.0
