paenian/bb8/bb8_club/Dome STL Files/BB8 Antenna-2 Base-2.stl

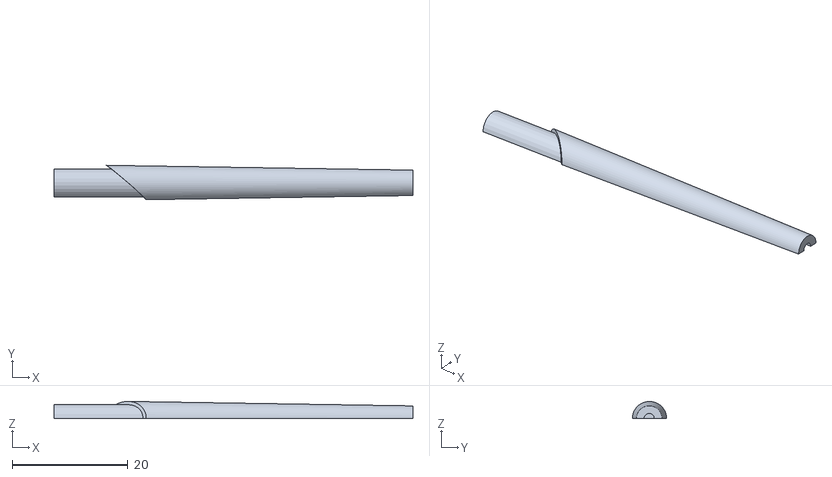
[picture p92: CAD file, 2018-01-01]
bb8_club/Dome STL Files/BB8 Antenna-2 Base-2.stl
62.1 x 5.95 x 2.97
