paenian/bb8/body/rhombicuboctahedron_clean/printing/face26.stl

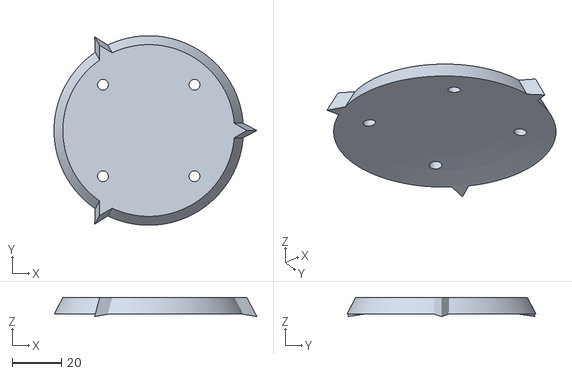
[picture p93: CAD file, 2016-11-15]
body/rhombicuboctahedron_clean/printing/face26.stl
82.8 x 77.2 x 7.85
