paenian/bb8/hamster/inside_hook.stl

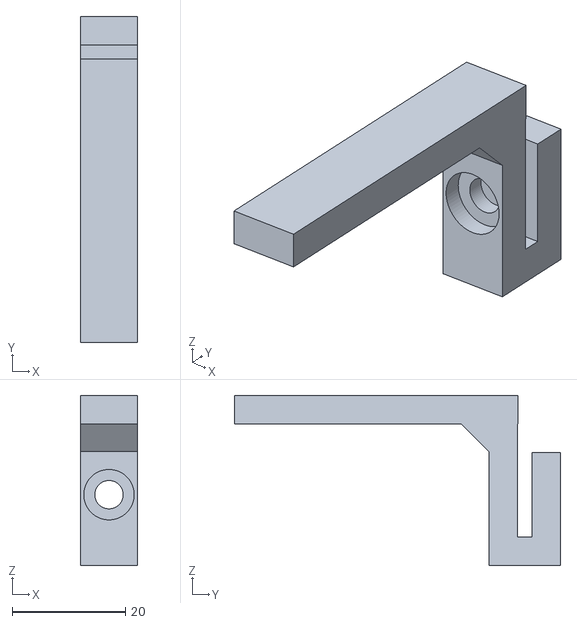
[picture p94: CAD file, 2017-02-14]
hamster/inside_hook.stl
10.0 x 57.5 x 30.0
