paenian/bb8/bb8_club/Dome STL Files/BB8 Dome Ring Section x3 V3.stl

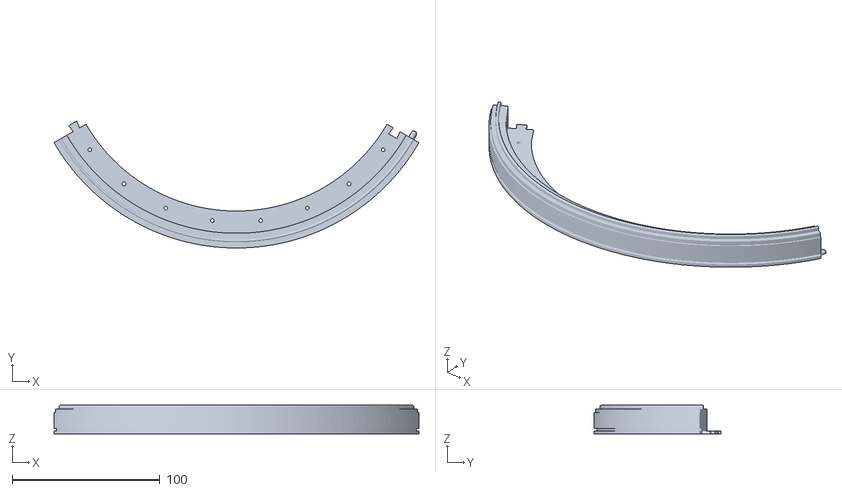
[picture p95: CAD file, 2018-01-01]
bb8_club/Dome STL Files/BB8 Dome Ring Section x3 V3.stl
246.8 x 85.9 x 19.4
