paenian/bb8/body/rhombicuboctahedron/assembled/face1.stl

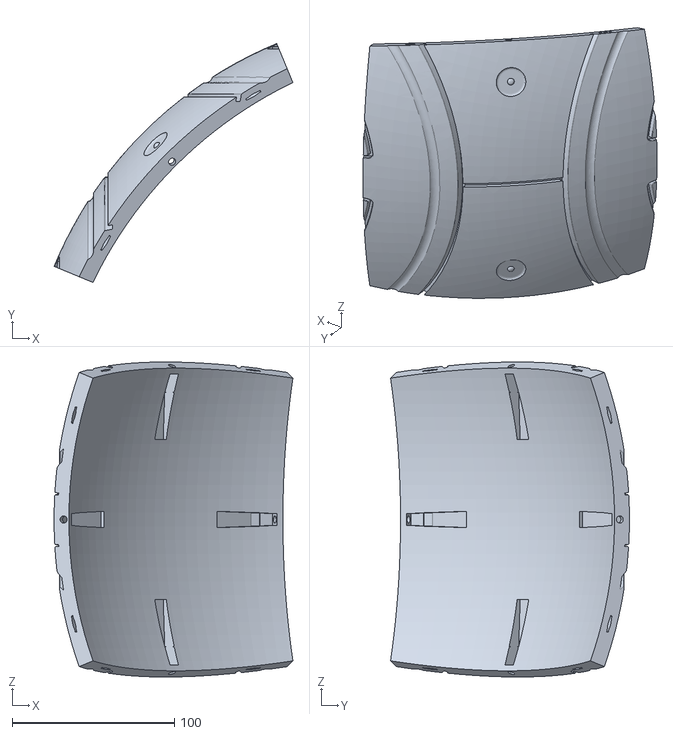
[picture p96: CAD file, 2016-05-04]
body/rhombicuboctahedron/assembled/face1.stl
147.3 x 147.4 x 194.3
