paenian/bb8/body/thermoformer/printing/bus.stl

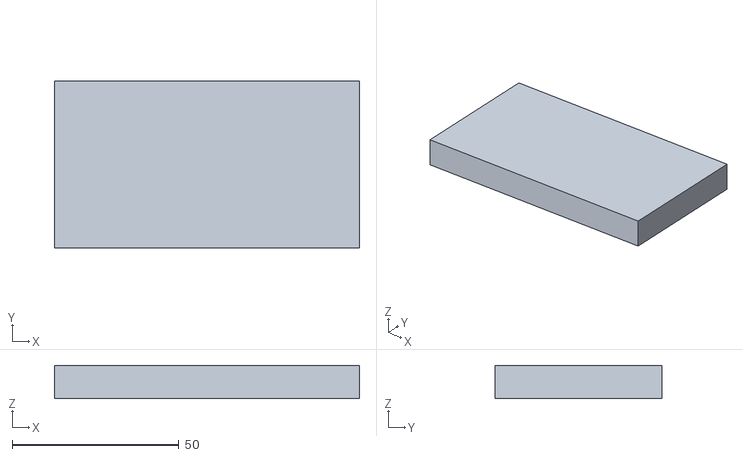
[picture p97: CAD file, 2016-08-04]
body/thermoformer/printing/bus.stl
91.5 x 50.0 x 10.0
