paenian/bb8/bb8_club/Body Stage STL Files/Panels/Panel 1 V506mm 1 of 2 V2 -1mm.stl

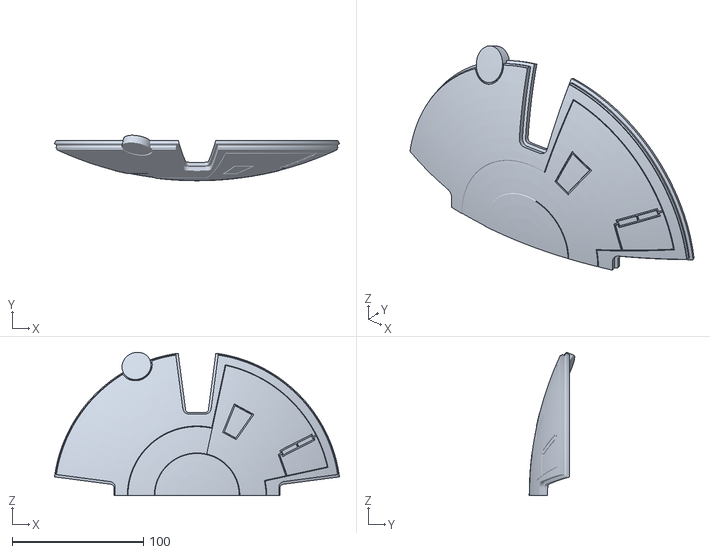
[picture p98: CAD file, 2018-01-01]
bb8_club/Body Stage STL Files/Panels/Panel 1 V506mm 1 of 2 V2 -1mm.stl
217.2 x 34.7 x 109.3
