paenian/bb8/bb8_club/Dome STL Files/BB8 Dome Skirt 3.stl

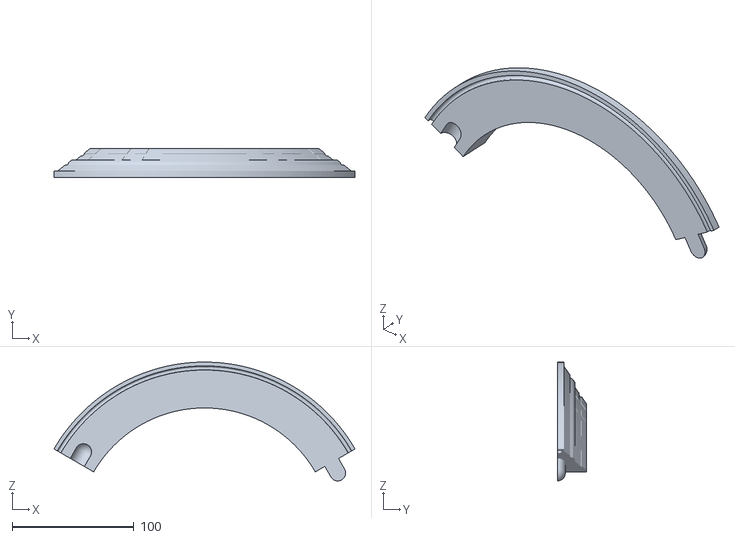
[picture p99: CAD file, 2018-01-01]
bb8_club/Dome STL Files/BB8 Dome Skirt 3.stl
246.8 x 23.9 x 97.5
