paenian/bb8/body/thermoformer/printing/head_cage.stl

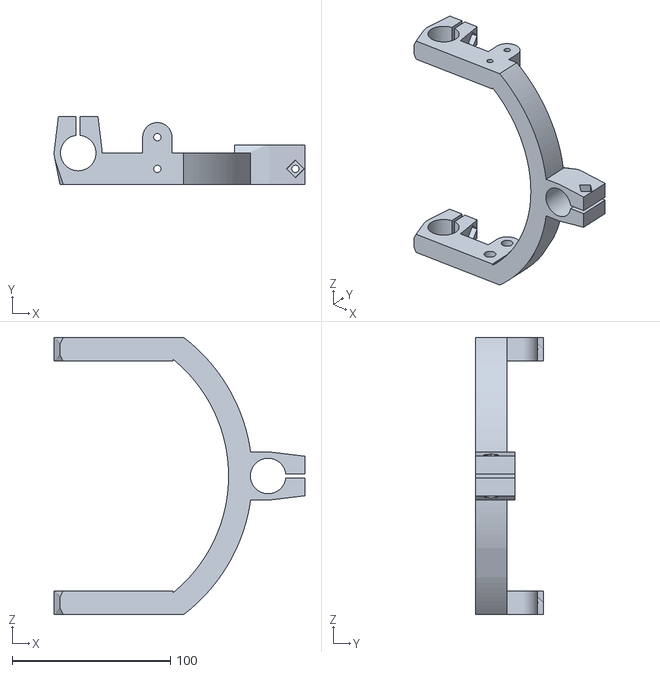
[picture p100: CAD file, 2016-08-04]
body/thermoformer/printing/head_cage.stl
158.4 x 43.2 x 175.0
