paenian/bb8/bb8_club/Dome STL Files/BB8 Dome Skirt 2.stl

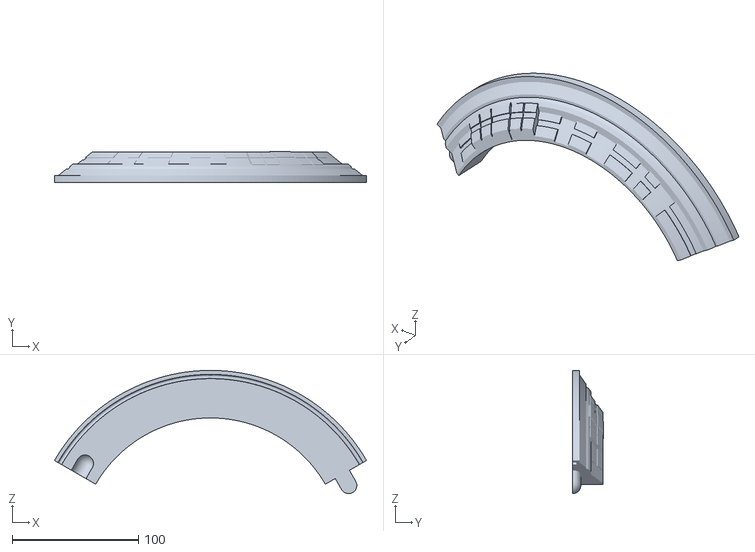
[picture p101: CAD file, 2018-01-01]
bb8_club/Dome STL Files/BB8 Dome Skirt 2.stl
246.8 x 24.3 x 97.5
