paenian/bb8/body/thermoformer/printing/petal5.stl

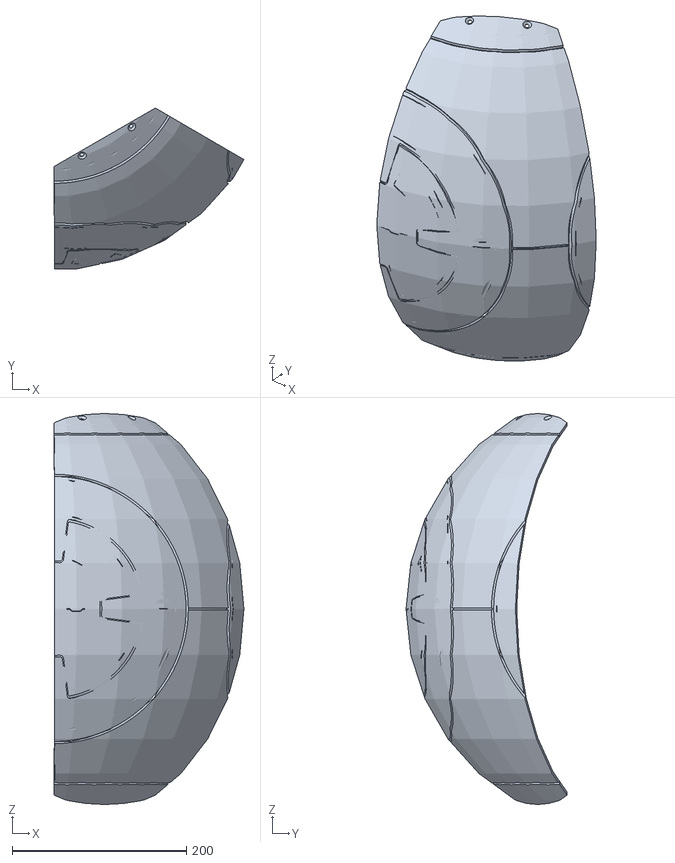
[picture p102: CAD file, 2016-07-04]
body/thermoformer/printing/petal5.stl
217.9 x 184.7 x 448.7
