paenian/bb8/bb8_club/BB-8 Parts for Large Format Printers/assembled.scad

rad = 254;

%cylinder(r=150, h=50);

rotate([0,-72,0]) translate([0,0,-rad])  rotate([0,0,60]) translate([-40+4,0,55.4+6]) mirror([0,0,1]) import("Triangle 1.stl");
translate([0,0,-rad]) translate([-40,0,55.4]) mirror([0,0,1]) import("Triangle 2.stl");

import("Orange Ring 1.stl");

https://www.youtube.com/watch?v=0oH8l1mbsUc
