paenian/bb8/(list of files, cad)

Other CAD files:
bb8_club/Body Stage STL Files/Orange Rings/Orange Ring 3 V506mm 1 of 4 -1mm.stl
body/rhombicuboctahedron/printing/face11.stl
body/rhombicuboctahedron_clean/printing/face22.stl
bb8_club/BB-8 Parts for Large Format Printers/Triangle 1.stl
bb8_club/Body Stage STL Files/Panels/Panel 6 V506mm 2 of 2 -1mm.stl
bb8_club/Body Stage STL Files/Triangles/Triangle1 - 3 of 3 - overlap.stl
body/rhombicuboctahedron/assembled/face11.stl
body/rhombicuboctahedron/assembled2/face7.stl
body/rhombicuboctahedron/printing/face5.stl
body/rhombicuboctahedron_clean/assembled/face22.stl
bb8_club/Body Stage STL Files/Orange Rings/Orange Ring 1 V506mm 2 of 4 -1mm.stl
bb8_club/Body Stage STL Files/Panels/Panel 3 V506mm 2 of 2 -1mm.stl
bb8_club/Body Stage STL Files/Triangles/Triangle1 - 1 of 3 - underlap.stl
bb8_club/Dome STL Files/Quarter Cut STL/BB8 Dome Panel 2 Mag QTR.stl
body/rhombicuboctahedron/assembled/face18.stl
body/rhombicuboctahedron/assembled2/face25.stl
body/rhombicuboctahedron/printing2/face12.stl
body/rhombicuboctahedron_clean/assembled/face18.stl
body/rhombicuboctahedron_clean/printing/face14.stl
bb8_club/Body Stage STL Files/Orange Rings/Orange Ring 2 V506mm 2 of 4 -1mm.stl
bb8_club/Body Stage STL Files/Panels/Panel 5 V506mm 1 of 2 -1mm.stl
bb8_club/Body Stage STL Files/Triangles/Triangle2 - 3 of 3 - overlap.stl
body/rhombicuboctahedron/assembled/face2.stl
body/rhombicuboctahedron/printing/face20.stl
body/rhombicuboctahedron_clean/assembled/face1.stl
bb8_club/Body Stage STL Files/Orange Rings/Orange Ring 1 V506mm 4 of 4 -1mm.stl
bb8_club/Body Stage STL Files/Panels/Panel 2 V506mm 1 of 2 -1mm.stl
bb8_club/Body Stage STL Files/Triangles/Triangle1 - 2 of 3 - underlap.stl
body/rhombicuboctahedron/assembled/face23.stl
body/rhombicuboctahedron/assembled2/face10.stl
body/rhombicuboctahedron/printing/face2.stl
body/rhombicuboctahedron/printing2/face5.stl
body/rhombicuboctahedron_clean/assembled/face19.stl
body/rhombicuboctahedron_clean/printing/face21.stl
body/thermoformer/printing/leftgear.stl
bb8_club/Body Stage STL Files/Orange Rings/Orange Ring 3 V506mm 4 of 4 V2 -1mm.stl
bb8_club/Body Stage STL Files/Panels/Panel 3 V506mm 1 of 2 -1mm.stl
bb8_club/Body Stage STL Files/Triangles/Triangle1 - 3 of 3 - underlap.stl
body/rhombicuboctahedron/assembled/face3.stl
body/rhombicuboctahedron/assembled2/face12.stl
body/rhombicuboctahedron/printing/face6.stl
body/rhombicuboctahedron/printing2/face22.stl
body/rhombicuboctahedron_clean/assembled/face24.stl
body/thermoformer/printing/rightmotor_carrier.stl
bb8_club/Body Stage STL Files/Orange Rings/Orange Ring 2 V506mm 3 of 4 V2 -1mm.stl
bb8_club/Body Stage STL Files/Panels/Panel 4 V506mm 2 of 2 -1mm.stl
bb8_club/Body Stage STL Files/Triangles/Triangle1 - 1 of 3 - overlap.stl
body/rhombicuboctahedron/assembled2/face4.stl
body/rhombicuboctahedron/printing/face13.stl
body/rhombicuboctahedron/printing2/face25.stl
body/rhombicuboctahedron_clean/assembled/face15.stl
body/rhombicuboctahedron_clean/printing/face25.stl
body/thermoformer/printing/rightcapcap.stl
bb8_club/Body Stage STL Files/Orange Rings/Orange Ring 3 V506mm 3 of 4 V2 -1mm.stl
bb8_club/Body Stage STL Files/Panels/Panel 2 V506mm 2 of 2 -1mm.stl
bb8_club/Dome STL Files/BB8 Antenna-2 Base-1.stl
body/rhombicuboctahedron/assembled/face20.stl
body/rhombicuboctahedron/assembled2/face3.stl
body/rhombicuboctahedron/printing/face9.stl
body/rhombicuboctahedron/printing2/face9.stl
body/rhombicuboctahedron_clean/assembled/face23.stl
body/rhombicuboctahedron_clean/printing/face23.stl
bb8_club/Body Stage STL Files/Orange Rings/Orange Ring 3 V506mm 2 of 4 -1mm.stl
body/rhombicuboctahedron/assembled/face9.stl
body/rhombicuboctahedron/assembled2/face22.stl
body/rhombicuboctahedron/printing/face15.stl
body/rhombicuboctahedron/printing2/face11.stl
body/rhombicuboctahedron_clean/assembled/face16.stl
body/rhombicuboctahedron_clean/printing/face17.stl
bb8_club/Body Stage STL Files/Orange Rings/Orange Ring 2 V506mm 1 of 4 -1mm.stl
bb8_club/Body Stage STL Files/Panels/Panel 1 V506mm 2 of 2 -1mm.stl
body/rhombicuboctahedron/assembled/face13.stl
body/rhombicuboctahedron/assembled2/face2.stl
body/rhombicuboctahedron/printing/face18.stl
body/rhombicuboctahedron/printing2/face6.stl
body/rhombicuboctahedron_clean/assembled/face20.stl
body/rhombicuboctahedron_clean/printing/face5.stl
bb8_club/Body Stage STL Files/Orange Rings/Orange Ring 2 V506mm 4 of 4 V2 -1mm.stl
body/thermoformer/motor_mount.scad
hamster/hamster.scad
body/rhombicuboctahedron/sphere2.scad
bb8_club/Body Stage STL Files/Panels/Panel 6 V506mm 1 of 2 V2 -1mm.stl
bb8_club/Dome STL Files/BB8 Antenna 1 1of2 V3.stl
bb8_club/Dome STL Files/BB8 Antenna 1 2of2 V3.stl
bb8_club/Dome STL Files/BB8 Antenna-2 Top x2.stl
bb8_club/Dome STL Files/BB8 DMM High Caster Race v8.stl
bb8_club/Dome STL Files/BB8 DMM Low Caster Race v9.stl
bb8_club/Dome STL Files/BB8 Dome Plate Lite v8 x3.stl
bb8_club/Dome STL Files/BB8 Dome Skirt 1.stl
bb8_club/Dome STL Files/BB8 Holo V6 Fixed.stl
bb8_club/Dome STL Files/BB8 PSI Housing V1.stl
bb8_club/Dome STL Files/BB8 Pie Panel 2 V2 mag.stl
bb8_club/Dome STL Files/BB8 Radar Eye V12 Lens Cutting Guide.stl
bb8_club/Dome STL Files/Dome Logic Housings v3.stl
bb8_club/Dome STL Files/Dome Logic Lens v4.stl
body/rhombicuboctahedron/assembled/face0.stl
body/rhombicuboctahedron/assembled/face10.stl
body/rhombicuboctahedron/assembled/face12.stl
body/rhombicuboctahedron/assembled/face14.stl
body/rhombicuboctahedron/assembled/face15.stl
body/rhombicuboctahedron/assembled/face16.stl
body/rhombicuboctahedron/assembled/face17.stl
body/rhombicuboctahedron/assembled/face19.stl
body/rhombicuboctahedron/assembled/face21.stl
body/rhombicuboctahedron/assembled/face22.stl
body/rhombicuboctahedron/assembled/face25.stl
body/rhombicuboctahedron/assembled/face5.stl
body/rhombicuboctahedron/assembled/face6.stl
body/rhombicuboctahedron/assembled/face7.stl
body/rhombicuboctahedron/assembled/face8.stl
body/rhombicuboctahedron/assembled2/face0.stl
body/rhombicuboctahedron/assembled2/face1.stl
body/rhombicuboctahedron/assembled2/face11.stl
body/rhombicuboctahedron/assembled2/face13.stl
body/rhombicuboctahedron/assembled2/face14.stl
body/rhombicuboctahedron/assembled2/face15.stl
body/rhombicuboctahedron/assembled2/face16.stl
body/rhombicuboctahedron/assembled2/face17.stl
body/rhombicuboctahedron/assembled2/face18.stl
body/rhombicuboctahedron/assembled2/face19.stl
body/rhombicuboctahedron/assembled2/face20.stl
body/rhombicuboctahedron/assembled2/face21.stl
body/rhombicuboctahedron/assembled2/face23.stl
body/rhombicuboctahedron/assembled2/face5.stl
body/rhombicuboctahedron/assembled2/face9.stl
body/rhombicuboctahedron/printing/face1.stl
body/rhombicuboctahedron/printing/face10.stl
body/rhombicuboctahedron/printing/face12.stl
body/rhombicuboctahedron/printing/face14.stl
body/rhombicuboctahedron/printing/face16.stl
body/rhombicuboctahedron/printing/face17.stl
body/rhombicuboctahedron/printing/face19.stl
body/rhombicuboctahedron/printing/face21.stl
body/rhombicuboctahedron/printing/face22.stl
body/rhombicuboctahedron/printing/face23.stl
body/rhombicuboctahedron/printing/face24.stl
body/rhombicuboctahedron/printing/face3.stl
body/rhombicuboctahedron/printing/face4.stl
body/rhombicuboctahedron/printing/face7.stl
body/rhombicuboctahedron/printing/face8.stl
body/rhombicuboctahedron/printing/square.stl
body/rhombicuboctahedron/printing/triangle.stl
body/rhombicuboctahedron/printing2/face0.stl
body/rhombicuboctahedron/printing2/face1.stl
body/rhombicuboctahedron/printing2/face10.stl
body/rhombicuboctahedron/printing2/face13.stl
body/rhombicuboctahedron/printing2/face15.stl
body/rhombicuboctahedron/printing2/face16.stl
body/rhombicuboctahedron/printing2/face18.stl
body/rhombicuboctahedron/printing2/face19.stl
body/rhombicuboctahedron/printing2/face21.stl
body/rhombicuboctahedron/printing2/face23.stl
body/rhombicuboctahedron/printing2/face24.stl
body/rhombicuboctahedron/printing2/face3.stl
body/rhombicuboctahedron/printing2/face4.stl
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
