paenian/bb8/bb8_club/BB8 Builders Printing Service Providers 20-Feb-2016.pdf

BB8 Builder Printing Service Providers
Last Updated: | 20-Feb-16
| 3D Printer | | | Recommened | Print
Name | Make/Model | Location Filament Settings Used Hour Rate
Eric Ameres | Makerfarm i3V 12" | USA | PLA | Yes | $6.50
Micke Askernäs | Custom | Sweden | PLA | Yes | $7.00€
Steven Bornhoeft | Ultimaker2 | USA | PLA | Yes | $8.00
Naila Brown | FlashForge Creator Pro | USA | PLA | Yes | $6.50
Adam Leach | FlashForge Creator Pro | USA | PLA | Yes | $5.50
Samantha Joseph | LulzBot Taz 5 | USA | PLA | Yes | $5.00
Jesse Maricelli | FlashForge Creator Pro | USA | ABS | Yes | $6.50
Rick McCaskill | Ultimaker Original | CAN | PLA | Yes | $8.60C
Brent Picha | ROBO3D | USA | PLA | Yes | $5.00
Pascal Poeck | Printrbot | Luxemburg | PLA | Yes | $7.00€
Michael Erwin | MakerBot Replicator2 | USA | PLA | Yes | $6.50
