paenian/bb8/(commit log)

2016-04-01 Dodecahedron in OpenSCAD.
    Based on the spere size, requires a 300mm diameter print area. Not small.
    I plan to model the droid's sphere, then have different methods to cut it
    into smaller pieces for printing.
    First is the dodecahedron, 12 big pieces; then I'll try to make a soccer
    ball, a truncated icosahedron - 32 smaller pieces.
    Paul
    [dodeca.stl, sphere.scad, tetra.stl]
2016-04-13 Central screwholes to hold the panels together.
    Also made a half-size version; currently to print it up and test the single-screw method.
    Next step is to start mapping the BB8 texture onto the panels - which'll make every one of them unique.
    I'm hoping that the rigidity and ease of assembly make up for that :-)
    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
    [dodeca.stl, dodeca_half.stl, sphere.scad]
2016-04-26 Added a rhombicuboctahedronal configuration
    The rhombicuboctahedron is nice because it's smaller faces, but more
    importantly exibits the same symmetry that BB8 does - so the joints etc.
    should be less noticable.
    Plan to make pockets in the corners to hold washers, biscuit-joint
    style, and make pocket screwholes for the centers of the faces...
    possibly only the square faces.
    There are 18 squares, roughly 8"x8", and 8 triangles. It should be
    /barely/ printable - full size - on most 8" printers.
    I'll try skin it with bb8 texture, but I haven't found a good
    full-sphere model.
    [sphere.scad]
2016-04-27 Rhombioctahedron complete.
    The screwholes aren't accurate, though, and haven't been added to rhe trangles yet.
    Skin has been applied, though :-)
    Todo: put some washer slots in the corners.
    Not sure we need screws in the triangles, but I think it'd help with the strength.
    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
    [face1.stl, face3.stl, sphere.scad, sphere2.scad]
2016-04-27 Removing old stls.
    [face1.stl, face3.stl]
2016-04-27 Now there are screwholes everywhere. Should be ready to print!
    Assembly requires 16mm M4 socket-cap screws - dome heads are too big - and M4 square nuts.
    The nut traps and screwholes are identical - just drop a nut in one side and a screw in the other.
    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
    [sphere.scad]
2016-04-27 Adding the square and triangular segments, ready for printing.
    Need to fire out a test or two.
    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
    [square_notexture.stl, triangle_notexture.stl]
2016-04-29 Updated squares and triangles.
    Test print is under way.
    [sphere.scad, square.stl, square_notexture.stl, triangle.stl, triangle_notexture.stl]
2016-04-29 Added two washer slots per side.
    In order to make it accessible for charging, I plan to not put any washers in the triangles; that way they'll be easily removable (3 screws).
    The washers are sized for M5 washers... because I have a ton of them lying around.
    I feel weird that the screws are M4 and the washers are M5. I console myself because M5 washers are 10mm diameter, and ten is a nice round number.
    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
    [sphere.scad, square.stl, triangle.stl]
2016-05-02 Messed with the screws to have them completely hidden - nothing disturbs the outer surface.
    At their closest, the nut traps are 2mm from the surface - so you'll get at least 3 solid perimeters there.
    Also started messing with the Arduino 101 - just getting it to talk to the motor driver board... and figured out how to charge and use a LIPO battery. Nothing exciting yet.
    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
    [head_solid.stl, sphere.scad, square.stl, triangle.stl]
2016-05-04 body is done - notionally anyways.
    Printing tests now. Also made some folders, I need to work on the hamster and I feel like rodents need their own space.
    [dodeca.stl, dodeca_half.stl, face0.stl, face1.stl, face10.stl, face11.stl, face12.stl, face13.stl]
2016-05-04 Made up a sphere model without the washers.
    Instead uses two screws per face, because the test pieces weren't as strong as
    I'd like.
    Of course, the sphere gets stronger the more panels there are... but printing
    the whole thing to find out that it's too weak wouldn't be fun.
    I also modified the triangles, with a 1mm solid edge - to better accommodate
    magnets holding on the triangular panels. Figure I should give the triangles
    their best shot with magnets... otherwise I'll need at least one to have
    external access holes. I calculate that 1/2" magnets will give over 3lbs of
    force holding a triangle on, which sounds fine for a 12lb hamster...
    ...but I think the hamster needs to weigh more t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
    [face0.stl, face1.stl, face10.stl, face11.stl, face12.stl, face13.stl, face14.stl, face15.stl]
2016-05-04 A little cleanup.
    [face1.stl, face10.stl, face11.stl, face1_notexture.stl, face2.stl, face2_notexture.stl, face3.stl, face3_notexture.stl]
2016-05-05 Triangles with two connectors ready to print.
    Added a few progress/planning READMEs.
    [face0.stl, face1.stl, face10.stl, face11.stl, face12.stl, face13.stl, face14.stl, face15.stl]
2016-05-06 Further refinements to the screwholes, to try and make them print more easily without using supports.
    Worst case, might have to design supports into the parts :-(
    Right now, though, the printed parts are functional, just a bit messy - the inner surface needs sanding.
    Using my 80mm omniwheels I don't think I'll need to fill in the channels or anything - certainly I don't intend to do that before testing it out.
    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
    [face0.stl, face1.stl, face10.stl, face11.stl, face12.stl, face13.stl, face14.stl, face15.stl]
2016-05-06 Starting to layout the parts for the hamster.
    Given short motor shafts, I'm thinking about using belts to drive the wheels - plus then I can switch the gear ratio up a bit.
    I think the plan laid out here is a good one.
    [_adapter.stl, hamster.scad]
2016-05-09 Working on the body.
    With perpendicular wheels, I think it's best to do an axle and belt drive system... so that's what I'm doing.
    [arduino.scad, configure.scad, hamster.scad, pins.scad, sphere2.scad]
2016-05-11 Playing with battery size/dimensions.
    I think the current layout is final. Now to design the bits...
    [hamster.scad]
2016-05-12 Axle ends added.
    The axle is threaded through with an M4 bolt, and uses 4 pulleys - two in each adapter. One adapter has the drive gear printed in, using a GT2 belt profile.
    Thanks to droftarts on Thingiverse for his pulley library: http://www.thingiverse.com/thing:16627 and especially for releasing it with a creative commons share-alike license.
    I haven't printed the parts, and will likely need to modify the wheel interface bits - I guessed sizes from memory.
    droftarts
    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
    [axle_adapters.scad, configure.scad, drive_axle.stl, idle_axle.stl, motor_adapter.scad, pulley.scad]
2016-05-13 Added motor mount, adjusted axle mounting.
    Axle mounts work! Motor mounts printing.
    w
    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
    [_adapter.stl, axle_adapters.scad, configure.scad, drive_axle.stl, idle_axle.stl, motor_mount.scad, motor_mount.stl, motor_shaft_adapter.scad]
2016-05-16 Working on the hamster body
    It should be basically complete - missing mounting holes for the electronics et al, but I want to get the motors in before I finalize placement.
    I need to think about head movement, too - or at least head attachment - so that I can put the electronics someplace where they won't affect that.
    What's the maximum head deflection?
    Should I have fixed bounce limiters, or rely only on the head's internal guide?
    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
    [configure.scad, hamster.scad, hamster.stl, motor_arm.stl, motor_mount.scad, motor_mount.stl]
2016-05-20 Doubled the teeth on the drive gear.
    Motor runs at 300rpm with a 20 tooth gear; this drive gear is 41 teeth, so output will be about 150RPM.
    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
    [axle_adapters.scad, drive_axle.stl, pulley.scad]
2016-05-21 Testing the bluetooth connection.
    I can send data using the silly test app. Not bad.
    Doesn't seem like there's an app I can use as a controller directly... might have to write my own Android app for it.
    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
    [BLEMotorTest.ino, Motor.h, motor_test.ino]
2016-05-21 Motor test is functional!
    Can control all four motors from a stock android app - nrfMasterControlPanel - by sending integers manually. Clearly we'll need to make some improvements, but it's a start :-P
    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
2016-05-23 Elongated the axle adapters.
    Now they meet in the middle, and hold two bearings each - 4 per wheel.
    The others were a little binding.
    Also centered the wheels, which means the motors have a higher cross-load.
    I might make the motor mounts bigger, or offset their mounting points to compensate.
    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
    [axle_adapters.scad, axles.stl, idle_axle.stl]
2016-05-26 Motors are more offcenter than planned...
    so I made the mount thick, and doubled up the screws.
    [motor_mount.scad, motor_mount.stl]
2016-06-21 Playing with stability a lot - and I made a stand for Maker Faire :-)
    This design is becoming worryingly cumbersome, though - the shell weighs too much for the hamster, and the hamster isn't reactive enough to stabilize anything. Really debating starting up an axle drive version instead :-(
    I do have my giant printer (the Doppelbot - see the other repos) running, so I can experiment with lighter sphere designs.
    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
    [arm.stl, center.stl, stand.scad]
2016-06-22 Some cleanup, and exploring other sphere options given axle drive.
    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
    [BodyBottom.stl, BodyTop.stl, dodeca.stl, dodeca_half.stl, face0.stl, face1.stl, face10.stl, face11.stl]
2016-07-03 Working on a new axle-drive idea.
    Endcaps are driven by individual motors riding on a shared bus, which also carries the weight-shifting apparatus for turning and spinning.
    Focus is on getting a drivable bot going, so spinning will be phase 2... or 3, after the head is phase 2.
    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
    [bearing.scad, configure.scad, sphere.scad, sphere2.scad]
2016-07-03 interim commit - first STLs
    [configure.scad, leftcap.stl, petal0.stl, petal1.stl, petal2.stl, petal3.stl, petal4.stl, petal5.stl]
2016-07-04 Dual motor mount ready
    It uses the offset shaft of the motor to perfect the tension. Two drives for more power with small motors.
    Includes bus attachment screws.
    [motor_mount.scad, sphere2.scad]
2016-07-04 Increased the size of the gears - maximize the offset weight of the motors.
    Considering using belts instead... gear ratio stands at 67:31, so about half-speed.
    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
    [sphere2.scad]
2016-07-04 Endcaps, motor drive gears and motor carriers are done.
    Will print a test set soon - waiting on parts for my big printer. Angles for the texture need to be looked at first. Next step will be the tilt mechanism, and mocking up a spacer for the head mechanism.
    The axle design is less elegant than my hamster :-( But at least modular enough to get a ball-rolling test before designing the entire thing.
    Electronics are behind, so I'll be working on remote control while this set is printing.
    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
    [configure.scad, leftgear.stl, leftmotor_carrier.stl, petal0.stl, petal1.stl, petal2.stl, petal3.stl, petal4.stl]
2016-07-05 Minor updates - still in progress.
    [sphere2.scad]
2016-07-06 Still running interim commits. Mocking up the innards.
    I'll start printing once I'm confident in the drive and tilt.
    [leftgear.stl, leftmotor_carrier.stl, motor_mount.scad, rightgear.stl, rightmotor_carrier.stl, sphere2.scad]
2016-07-07 Messing about a bit.
    [sphere2.scad]
2016-07-08 Full mockup is in place; ready for test print. Debating doing a half-size mockup to test with.
    [motor_mount.scad, sphere2.scad]
2016-07-10 Ready for test prints on the endcaps and motor mounts.
    Petals will get some printed braces & screwholes, and then also get printed.
    I'll make some stiffening rings elsewhere in the sphere - the waist, etc.
    Head cage is close - it's missing the tilt mechanism; probably just a servo mount, but I need to test the servo to figure out how to mount it.
    Buses are mocked up - I'm going to put some mounting holes in for the electronics & braces.
    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
    [configure.scad, head_cage.stl, leftgear.stl, leftmotor_carrier.stl, rightgear.stl, rightmotor_carrier.stl, sphere2.scad]
2016-07-12 Testing the xbees :)
    [configure.scad]
2016-07-12 Thinking through pins, re-organizing the arduino code.
    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
    [configuration.h]
2016-07-15 Rebuilt everything - 10mm axis, still using 22mm flanged bearings.
    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
    [bus.stl, head_cage.stl, leftgear.stl, leftmotor_carrier.stl, rightgear.stl, rightmotor_carrier.stl, sphere2.scad]
2016-07-20 Regenerated everything - minor tweaks to the ball.
    Need to make some stiffening rings for the panels, then print the panels.
    [head_cage.stl, leftgear.stl, leftmotor_carrier.stl, rightgear.stl, rightmotor_carrier.stl, sphere2.scad]
2016-07-21 Working on the code.
    [configuration.h]
2016-07-22 More code work.
    Body is done, but not even close to tested. Controller is like, 1/4 done.
    [configuration.h]
2016-07-23 More work on the code.
    Need to spend some time tracing it - ensure that pins are sent properly.
    [configuration.h]
2016-07-23 Started work on the controller.
    Plan to mount the control electronics, then I can upload and test the code.
    Since it's all mesh network, monitoring what the controller broadcasts is relevant even before wiring up any of the recievers :-)
    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
    [controller.scad]
2016-07-25 Working on the code.
    Working model of controller is up, too - way oversized, so I can rearrange the innards.
    Controller works - sends good commands. Need a little more work on the body, so that I have something to read the commands :-)
    Plan to get body roll going, then tilt, then head motion.
    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
    [bot.stl, configuration.h, configure.scad, controller.scad, top.stl]
2016-07-25 making a waist stiffener, to attach the center of the petals to.
    [sphere2.scad]
2016-07-26 Playing with the waistband. Will have to recompile the sphere when I get back to a bigger computer.
    [bus.stl, head_cage.stl, leftgear.stl, leftmotor_carrier.stl, rightgear.stl, rightmotor_carrier.stl, sphere2.scad, waistband.stl]
2016-07-26 Recompiled the printable bits. Ready to make the rest of the sphere.
    [bus.stl, head_cage.stl, leftcapcap.stl, leftgear.stl, leftmotor_carrier.stl, rightcapcap.stl, rightgear.stl, rightmotor_carrier.stl]
2016-07-26 Adjusting the waist size.
    Will be printing the main shell soon.
    Need to update the innards to hold the motor controller, batteries and electronics; then can have a proper forwards/backwards test :-)
    [sphere2.scad, waistband.stl]
2016-07-26 Never had holes at the bottom of the petals... whoops.
    Caught it before printing, though :-) Will recompile the petals tonight.
    [sphere2.scad]
2016-08-01 Printing the shell, need to work out a servo mount for the tilt.
    Also need a good way to mount the electronic bits inside - perhaps finish the bus.
    [head_cage.stl, leftcapcap.stl, leftgear.stl, leftmotor_carrier.stl, rightcapcap.stl, rightgear.stl, rightmotor_carrier.stl, sphere2.scad]
2016-08-01 Added some tabs to make printing the sphere sections easier.
    [sphere2.scad]
2016-08-04 Added tabs to the petals to make printing easier.
    Working on the tilt mechanism. Once that's done, the next task is mounting the controls inside.
    That'll be the motion and control test, before adding the head.
    [bus.stl, head_cage.stl, leftcapcap.stl, leftgear.stl, leftmotor_carrier.stl, rightcapcap.stl, rightgear.stl, rightmotor_carrier.stl]
2016-08-04 making a bigger endcap hole, so I can get my hand in there.
    [sphere2.scad]
2016-08-08 Added the wishbone pendulum for the tilt weight.
    100mm length, 100mm drop - so weight can be about an inch thick, given 25mm for the shell, waistband and clearance.
    [sphere2.scad]
2016-08-08 interim commit... out of sync
    [sphere2.scad]
2016-08-09 Adding pendulum :-)
    [pendulum.stl]
2016-08-09 Updates to the swing arm, and new prints.
    [leftcapcap.stl, leftgear.stl, leftmotor_carrier.stl, rightcapcap.stl, rightgear.stl, rightmotor_carrier.stl, sphere2.scad, waistband.stl]
2016-08-09 newest head & pendulum
    [pendulum.stl]
2016-08-10 Added some holes to attach the servo to the pendulum.
    [leftcapcap.stl, leftgear.stl, leftmotor_carrier.stl, pendulum.stl, rightcapcap.stl, rightgear.stl, rightmotor_carrier.stl, sphere2.scad]
2016-09-07 Moved the waist band to be two bands, one top one bottom. This lets the head swing around freely, between the two bands.
    [sphere2.scad]
2016-10-14 playing with making an ice mold :-)
    [head.stl, mold.scad]
2016-10-19 Added some support for the Trellis controller.
    It lights up :-) Plan to use one row of buttons for battery control/display, the other 12 to play funny sounds in the head.
2016-10-21 playing with the rhombi again... it's a more elegant design :-)
    [sphere.scad]
2016-10-21 minor rotation... still technically fits on the bed.
    [sphere.scad]
2016-10-23 trying a vertex attachment instead
    [sphere.scad, sphere2.scad, square.stl, triangle.stl]
2016-10-23 Corner tabs implemented.
    [sphere.scad]
2016-10-23 Updated the build scripts, added some pokers to the corner tabs.
    The idea is that they'll lock in... and everything will fit perfectly, with the right orientation etc.
    [sphere.scad]
2016-10-28 New sphere design, for a holonomic hamster.
    Next up is code to get the hamster running - just XY position for now. I plan to remodel the hamster extensively, but want to get something moving before playing with the design.
    Sphere uses 1/4" 10-32 nylon screws into joint plates at each vertex - still a rhombicuboctahedron. This should give a smooth inside, and a smooth outside for rolling.
    Printing it up in clear PETG.
    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
    [configure.scad, corner.stl, face1.stl, face14.stl, face15.stl, face16.stl, face17.stl, face18.stl]
2016-10-29 Working through an actual protocol.
    Controller can send the body position, head position, etc, and reads battery voltages from afar.
2016-10-30 Should be completed controller code. Not tested, even a little.
    I've got some time to code without hardware, so hey. Go Cubs.
    Going to work on the body.
    Right now the test bed is just four omniwheel motors, so plan to
    get the motion going.
    Haven't figured out how to monitor the battery yet... I mean, just
    some voltage dividers and an analog in; but how to report it to
    the controller?
2016-10-30 Slight updates. Still not close on the body.
    I plan to use the body to dampen itself, so the sphere doesn't
    wobble too much. That means it'll use PID control, and an
    accelerometer on the base; more importantly for now I just want
    to put in the skeleton of code to handle that.
    [body_receiver.ino, control_transmitter.ino]
2016-11-06 Updated body code.
    [configuration.h]
2016-11-06 Tweaked the panel screwholes.
    Using 10-24 by 1/4" long nylon screws to hold the panels to the
    corners.
    You need to print one of each panel, and one corner per vertex.
    That works out to 24 vertices, with four screws each - 96 screws.
    McMaster-Carr sells the screws in packs of 100. Boom.
    Have fun tapping 96 holes! The sphere gets stronger with every panel
    added.
    [corner.stl, face1.stl, face14.stl, face15.stl, face16.stl, face17.stl, face18.stl, face19.stl]
2016-11-07 More coding.
    basic body movement should work; need some thorough testing.
    Next: battery monitoring. Boring, but important to get it right.
    [configuration.h]
2016-11-15 Half of the triangles were mirrored! I mistook the order of operations.
    Re-sliced everything just to be sure.
    Also added a new controller bottom, with a mount for Adafruit's powerboost 5000 and a push-button on/off switch.
    BB8 body has been built! Tested and working, the robot living in his ball:
    https://www.youtube.com/watch?v=s_wqE3xO_Gs
    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
    [bot.stl, controller.scad, corner.stl, face1.stl, face14.stl, face15.stl, face16.stl, face17.stl]
2016-12-06 Playing with the hamster.
    It needs to sit lower in the sphere - and I'd like to direct-drive the wheels, get some slop out of the system.
    [direct_hamster.scad]
2017-01-04 Working on a new hamster.
    Leaving a hollow center, this will have two rings - one for the drive system, and a second for the head.
    [new_hamster.scad]
2017-01-06 Working on the new hamster.
    todo:
    motor mount
    mounting holes on the spines for electronics, head
    [new_hamster.scad]
2017-01-09 Working out where the motors go :-)
    [new_hamster.scad]
2017-01-18 pecking
    will work on it more soon
    [new_hamster.scad]
2017-01-19 motor mounts :-)
    the hamster can have motors. Need to modify them so that one side takes
    a motor, and the other takes some flanged bearings - to support both
    sides of the wheel. Then the spines can be customized to hold batteries
    et al.
    [new_hamster.scad]
2017-01-23 dodecasphere 2
    Just stumbled across the rhombic dodecahedron. 12 faces, but each face
    is 4-sided - fewer edges, 24 instead of 30. Given that the
    rhombicuboctahedron has 48 edges and 26 faces, it's a decent reduction,
    and can be printed on a 300x300 bed.
    [sphere.scad]
2017-01-25 woo... working on a tri-wheel, open-core hamster.
    [new_hamster.scad, new_motor_mount.stl, new_spine.stl]
2017-02-09 Adding an idler ring around the waist.
    Idler ring will mount the head - pivoting from the center of the sphere.
    Also made the rest of the drive more configurable.
    The big idea is to leave space for a head counterweight - so that moving
    the head won't wiggle the body too much.
    [axles.stl, drive_axle.stl, hamster.stl, idle_axle.stl, idler_mount_arm.stl, motor_arm.stl, motor_mount.stl, motor_mount_arm.stl]
2017-02-13 Working on the upper ring
    This will support the head.
    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
    [idler_lift_arm.stl, idler_mount_arm.stl, motor_mount_arm.stl, motor_support_bearing.stl, new_hamster.scad, spine.stl]
2017-02-14 Minor fix to the controller, to fit stuff in.
    Working on mounting things inside BB8 - battery and head will go in the middle of each ring.
    [bot.stl, controller.scad, idler_lift_arm.stl, idler_mount_arm.stl, inside_hook.stl, motor_mount_arm.stl, motor_support_bearing.stl, new_hamster.scad]
2017-02-20 Playing with head mount, organizing code
    [battery_mount.stl, configuration.h, new_hamster.scad]
2017-02-26 Syncing up - minor updates only.
    [new_hamster.scad]
2018-01-01 Adding club files :-)
    [BB8 Antenna 1 1of2 V3.stl, BB8 Antenna 1 2of2 V3.stl, BB8 Antenna-2 Base-1.stl, BB8 Antenna-2 Base-2.stl, BB8 Antenna-2 Top x2.stl, BB8 DMM High Caster Race v8.stl, BB8 DMM Low Caster Race v9.stl, BB8 Dome Panel 2 Mag QTR.stl]
2018-01-22 Moved the dodecahedron code - rhombic lol
    [sphere.scad]
